hello/morpheus-board-top/README.md

Hello Morpheus Top Board repository 
===
