hello/morpheus-board-top/Morpheus_top/Morpheus_top_091614.xlsx

Comment | Description | Designator | Footprint | LibRef | Quantity
BAL-NRF02D3 | 50 ohm balun transformer for 2.45GHz ISM | B1 | BAL-ST-WLCSP | BAL-ST-5pin_DC-Flip | 1
0.1u | Chip capacitor | C1, C2, C3, C9, C11, C14, C16, C23, C44, C61 | CAP0402 | C_0.1u_10_50_X7R_0402 | 10
12p | Chip capacitor | C4, C5, C52, C53 | CAP0402 | C_12p_5_50_C0G_0402 | 4
1000p | Chip capacitor | C6 | CAP0402 | C_1000p_10_50_X7R_0402 | 1
0.047u | Chip capacitor | C7 | CAP0402 | C_0.047u_10_50_X7R_0402 | 1
2200p | Chip capacitor | C8, C20, C21, C22 | CAP0402 | C_2200p_5_16_STD_0402 | 4
4.7u | Chip capacitor | C10, C12, C17, C18, C19, C25, C26, C49 | CAP0603 | C_4.7u_20_6.3_X5R_0603 | 8
10u | Chip capacitor | C13, C24 | CAP0603 | C_10u_10_6.3_X5R_0603 | 2
22u | Chip capacitor | C15 | CAP0603 | C_22u_10_20_JB_0603 | 1
2.2 p | Chip capacitor | C32 | CAP0402 | C_2.2p_0.05_50_C0G_0402 | 1
1.0p | Chip capacitor | C33 | CAP0402 | C_2200p_5_16_STD_0402 | 1
1u | Chip capacitor | C43, C47, C48 | CAP0603 | C_1u_10_16_X5R_0603 | 3
220p | Chip capacitor | C46 | CAP0402 | C_220p_5_50_C0G_0402 | 1
4.7u | Chip capacitor | C54, C55 | CAP0402 | C_4.7u_10_10_JB_0402 | 2
100u | Chip capacitor | C56 | CAP1206 | C_100u_20_6.3_X5R_1206 | 1
Hole | general purpose hole | H1, H2, H3, H4 | HOLE_ROUND_1.7mm | Hole | 4
2.2n | SMD power inductor, 2.2uH | L1 | IND_0402 | L_2.2n_0.1_?_0.150_0.9_? | 1
SPU0414 | Knolwes Microphone | M1 | BGA4C170X246P3.00X3.75X90 | SPU0414HR5H | 1
SPH0611LR5H | Knolwes Microphone | M2 | SPH0611 | SPH0611LR5H | 1
53647-0374 | Molex 30-pin 0.635mm pitch plug connector | P1 | molex_53647-0374 | molex_53647-0374 | 1
HDR2.00-2x3-SM |  | P4, P5, P6 | HDR2.00-2X3-SMD | HDR2.00-2x3-SM | 3
Si1912EDH | Vishay Dual N-Channel MOSFET 1.8v drive 20V 1A | Q2 | SC-70-6 | Si1912EDH | 1
100K | Chip Resistor | R1 | RES0402 | R_100k_5_0.1_0402 | 1
10 | Chip Resistor | R4, R10, R44, R70, R71, R72, R73, R74, R75, R76, R77, R78 | RES0402 | R_10_1_0.1_0402 | 12
10k | Chip Resistor | R6, R61 | RES0402 | R_10k_5_0.1_0402 | 2
215K | Chip Resistor | R22, R24 | RES0402 | R_215K_1_0.1_0402 | 2
523k | Chip Resistor | R23, R25, R26, R27, R29, R30 | RES0402 | R_523k_1_0.1_0402 | 6
DNP | Chip Resistor | R28, R31, R81, R82 | RES0402 | R_0_jumper_0.1_0402, R_10k_5_0.1_0402 | 4
100 | Chip Resistor | R37, R38, R39 | RES0402 | R_100_1_0.1_0402 | 3
681 | Chip Resistor | R43 | RES0402 | R_681_1_0.1_0402 | 1
47k | Chip Resistor | R46 | RES0402 | R_47K_5_0.1_0402 | 1
AB-RTCMC-32.768kHz-AIGZ | Abracon I2C RTC w/ integrated XO | RTC0 | 8-CLCC | AB-RTCMC-32.768kHz-AIGZ | 1
2403-260-00001 | Knowles SMD speaker | SP1 | Knowles_2403-260-00001 | Knowles_2403-260-00001 | 1
nRF51822-QF | Multi-protocol Bluetooth Low Energy and 2.4GHz proprietary system-on-chip | U1 | VQFN40P600X600X100-48 | nRF51822_QF | 1
TSL4531 | Digital ambient light sensor | U2 | TSL4531 | TSL4531 | 1
NAU8814 | Nuvoton Audio Codec | U3 | QFN-24_0.5 | NAU8814 | 1
VCNL3020 | Proximity and ambient light sensor with IR emitter and I2C interface | U4 | vcnl3020 | VCNL3020 | 1
TPS79718 | LDO 1.8V SC70-5 | U11 | SOT65P212X110-5N | TPS79718DCK | 1
ILCX19-FB5F18-16.000MHz | ILSI ILCX19 16 MHz Crystal Oscillator | X1 | ILCX19 | ILCX19-FB5F18-16.000MHz | 1
FC-135 32.7680KA-AC3 | Epson 32kHz crystal, 9pF | X2 | Epson_FC-135 | Espon_FC-135 32.7680KA-AC3 | 1
ASDMB-12.000MHZ | ASDMB 12MHz Crystal Oscillator | X3 | ASDMB | ASDMB-12.000MHZ-LC-T | 1
