hello/morpheus-board-top/Morpheus_top/905-00003-EVT2.DXF

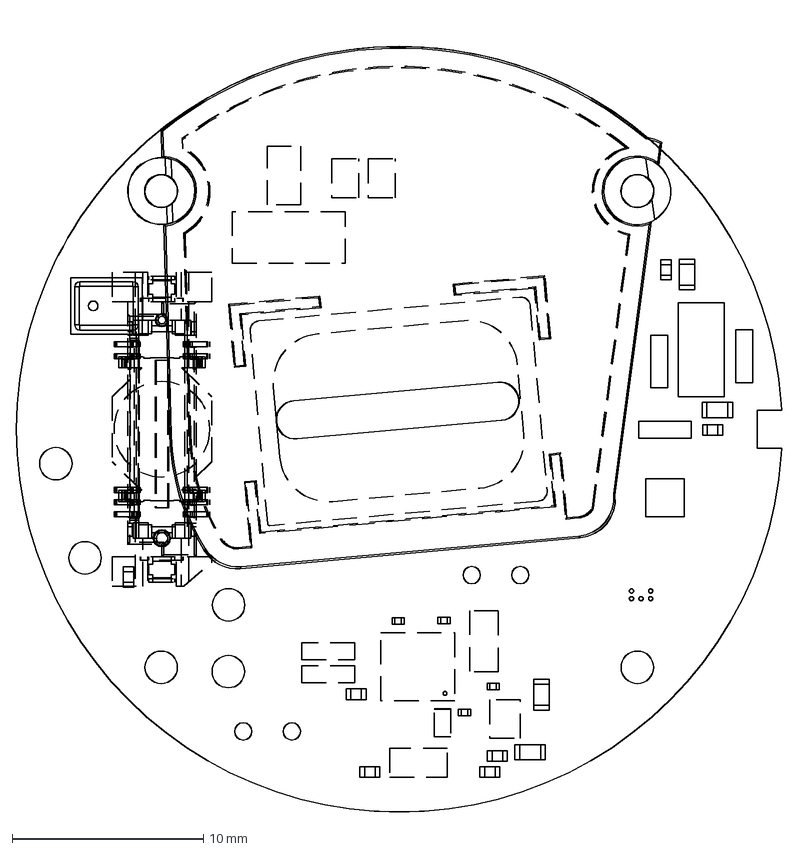
[picture p1: CAD file, 2014-11-20]
Morpheus_top/905-00003-EVT2.DXF
40.0 x 41.6 mm
