hello/morpheus-board-top/Morpheus_top/Bottom USB Board.DXF

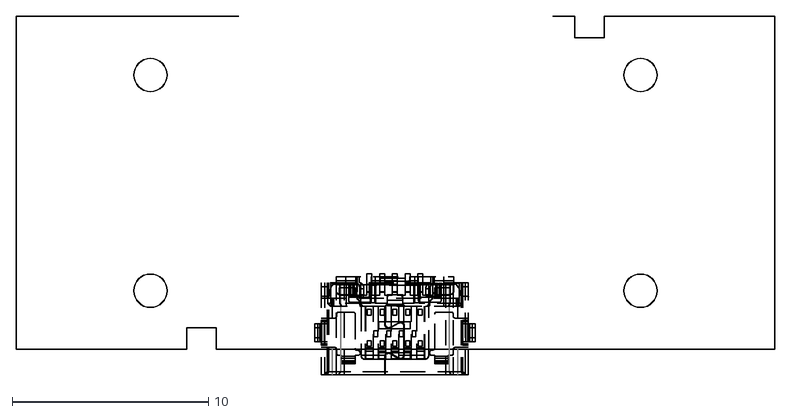
[picture p2: CAD file, 2014-11-20]
Morpheus_top/Bottom USB Board.DXF
38.7 x 18.3
