hello/morpheus-board-top/Morpheus_top/905-00003DXF.DXF

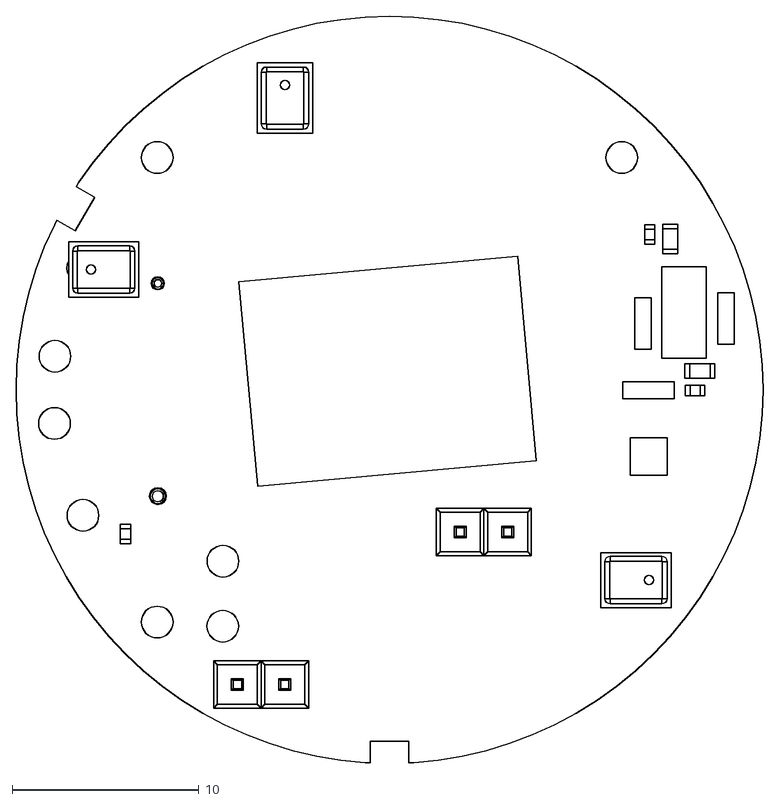
[picture p3: CAD file, 2014-11-20]
Morpheus_top/905-00003DXF.DXF
40.0 x 40.0
