hello/morpheus-board-top/Morpheus_top/905-00003-EVT3onetoone (1).DXF

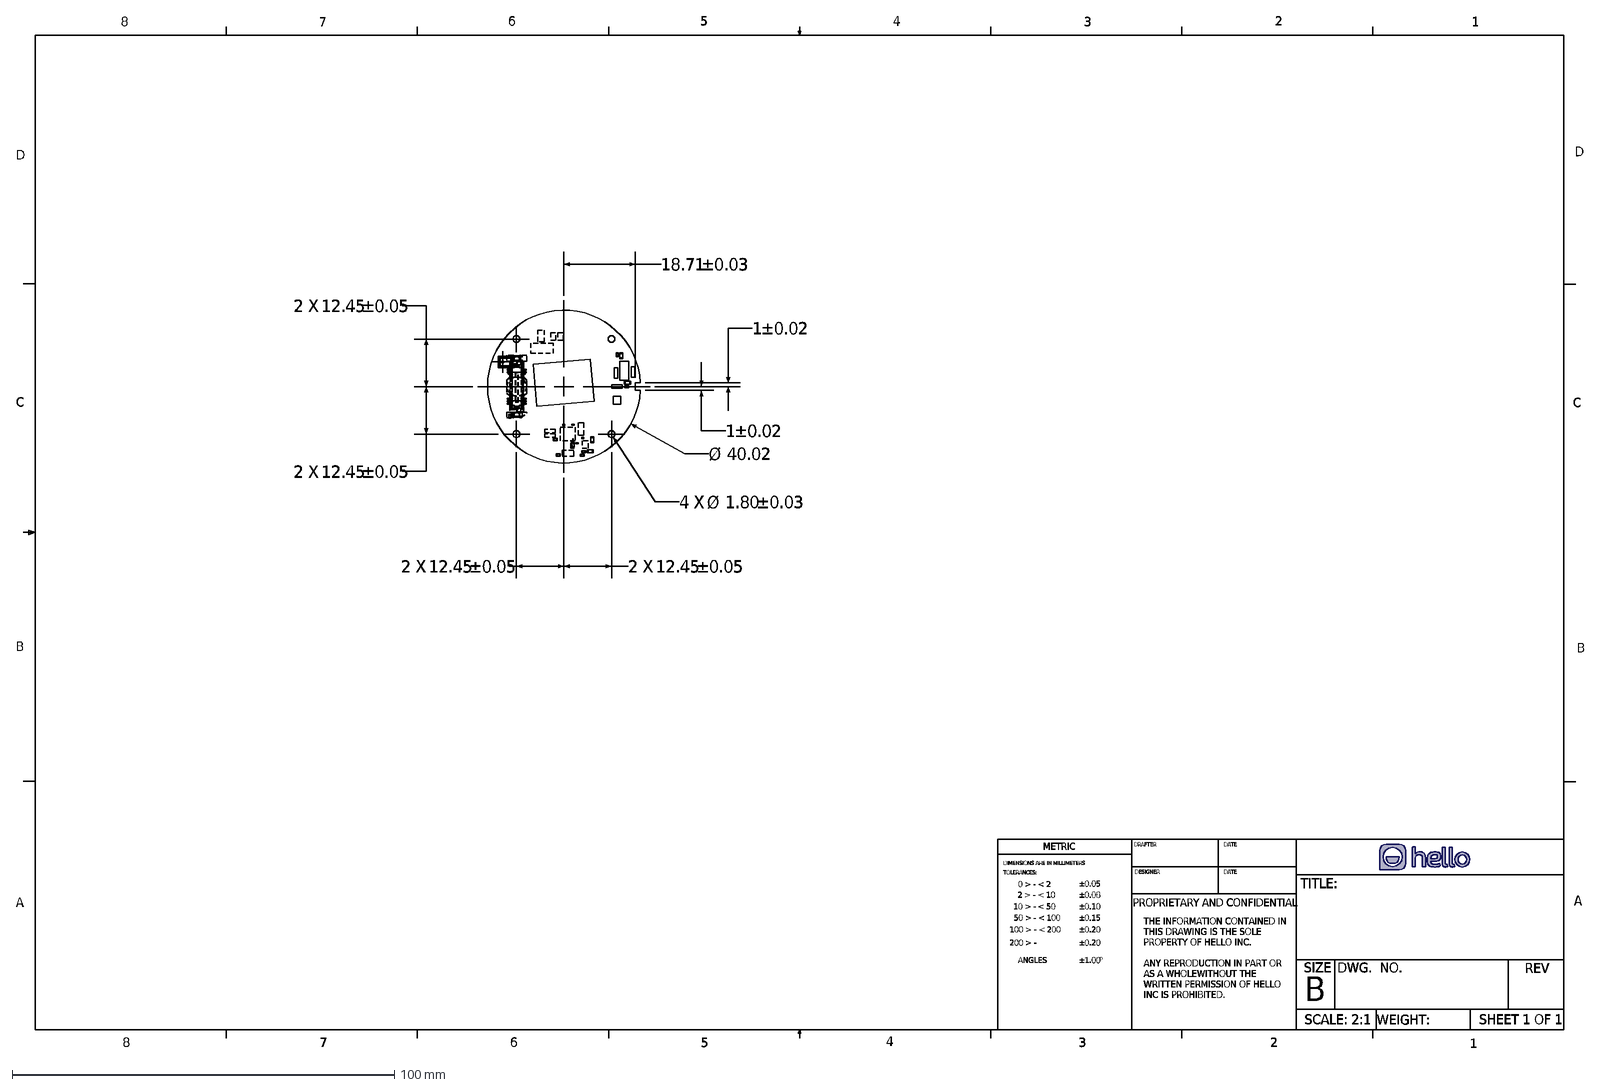
[picture p4: CAD file, 2014-11-20]
Morpheus_top/905-00003-EVT3onetoone (1).DXF
D
C
B
A
1
2
3
4
5
6
7
8
THE INFORMATION CONTAINED IN
THIS DRAWING IS THE SOLE
PROPERTY OF HELLO INC.
ANY REPRODUCTION IN PART OR
AS A WHOLEWITHOUT THE
WRITTEN PERMISSION OF HELLO
INC IS PROHIBITED.
PROPRIETARY AND CONFIDENTIAL
DIMENSIONS ARE IN MILLIMETERS
TOLERANCES:
DRAFTER
DESIGNER
DATE
TITLE:
SIZE
DWG. NO.
REV
WEIGHT:
SCALE: 2:1
METRIC
SHEET 1 OF 1
±
0.05
0 > - < 2
2 > - < 10
10 > - < 50
50 > - < 100
100 > - < 200
200 > -
0.08
0.10
0.15
0.20
ANGLES
1.00
°
4 X
Ø
1.80
±0.03
±0.02
18.71
40.02
2 X
12.45
±0.05
