hello/morpheus-board-top/Morpheus_top/40mm board.DXF

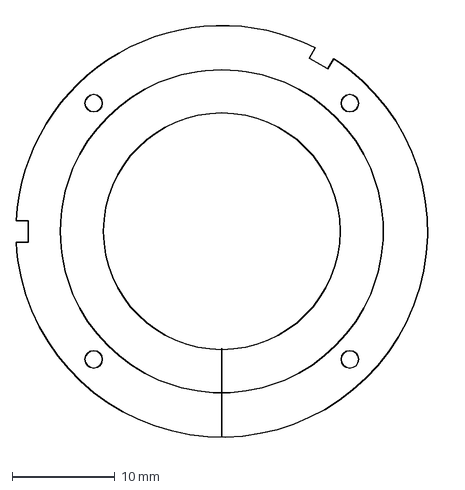
[picture p5: CAD file, 2014-11-20]
Morpheus_top/40mm board.DXF
42.0 x 42.1 mm
