hello/morpheus-board-top/Morpheus_top/Top Board only.DXF

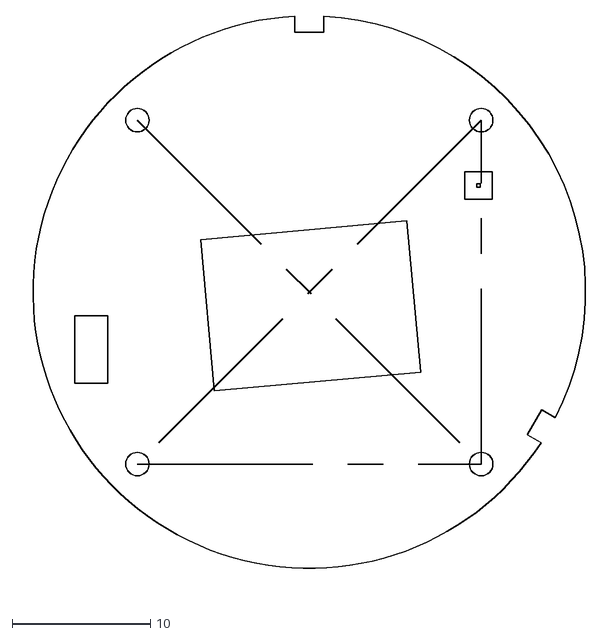
[picture p7: CAD file, 2014-11-20]
Morpheus_top/Top Board only.DXF
42.1 x 42.0
