hello/morpheus-board-top/Morpheus_top/Morpheus_top.step

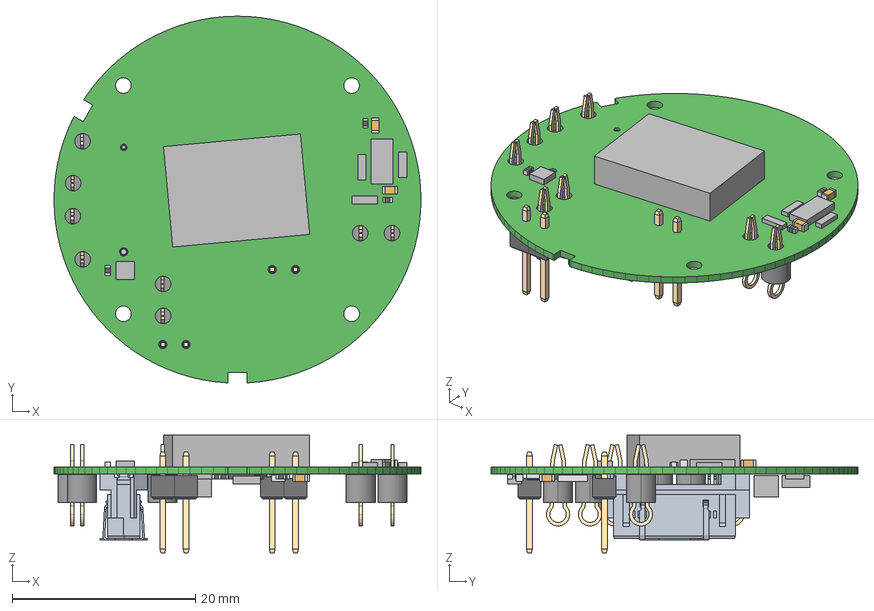
[picture p8: CAD file, 2014-06-07]
Morpheus_top/Morpheus_top.step
40.0 x 40.0 x 12.8 mm
Board
Extruded x 63
keystone_5006 x 8
User_Library-Header1x2_Header1_1 x 4
