hello/morpheus-board-top/(list of files, cad)

Other CAD files:
Morpheus_top/905-00003-04-DVTd.DWG
Morpheus_top/Antenna_sketch.DWG
Morpheus_top/Morpheus_top.DWG
