hello/morpheus-board-top/Morpheus_top/Morpheus_top_DVT_release_candidate_111414.PDF

Break Out Board Development

To the middle board

4 | | CCU_TXD

GSPI_MISO | 5 | | 8

TITLE Morpheus top | REV DVT

DATE | DRAWN BY D. Fusi | SHEET 1 OF 7

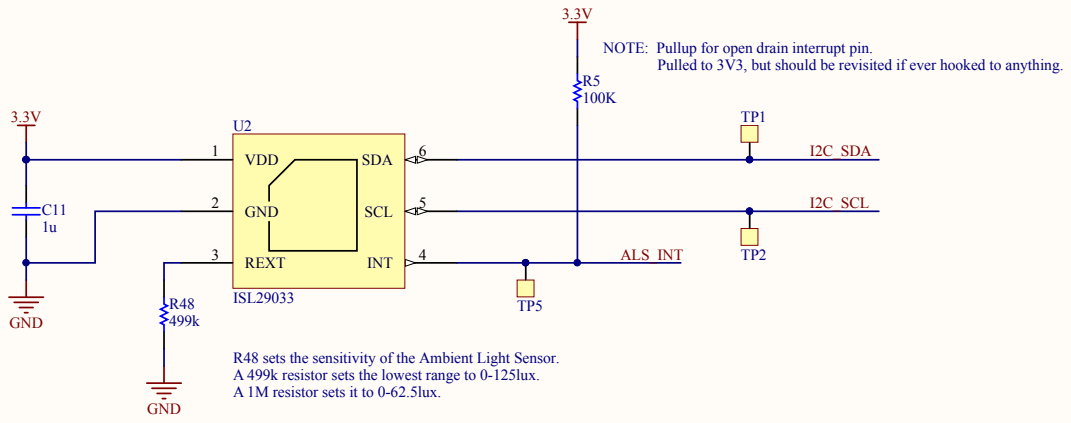
[picture p24: page 2]

NOTE: Pullup for open drain interrupt pin.

Pulled to 3V3, but should be revisited if ever hooked to anything.

R48 sets the sensitivity of the Ambient Light Sensor
A 499k resistor sets the lowest range to 0-125lux. A 1M resistor sets it to 0-62.5lux.

TITLE ALS DATE

DRAWN BY D . Fusi | S HEET 2 OF


5 | VDDC 4 | MIC+

MIC-C48 | 1u

VREF 22 | | | MIC_OUT

CSB/GPIO

EPAD 25 | MOUT

Codec

D ATE | DRAWN BY D . Fusi | S HEET 3 OF


max speaker power = 500mW
max sp7.9 mA @ 8 ohm impedance


pin 10 has to be NC according to

Proximity

D ATE | DRAWN BY D . Fusi | S HEET 5 OF


M1 is top port mic, M2 is bottom port mic. Only one can be installed at a time

High Pass Corner Frequency (32.2580645 Hz), Gain 2X


CLKOUT 2 Vss 3 Vcc 5

RTC_CLK#

FSPI_SEL | | R1 100K SWDCLK

FSPI_MISO | RTC_SDA

Install R2 to power 1.8V from middle board

LDO to provide 1.8V rather than getting it from middle board

Option for adjustable regulator version to produce ~1.85V

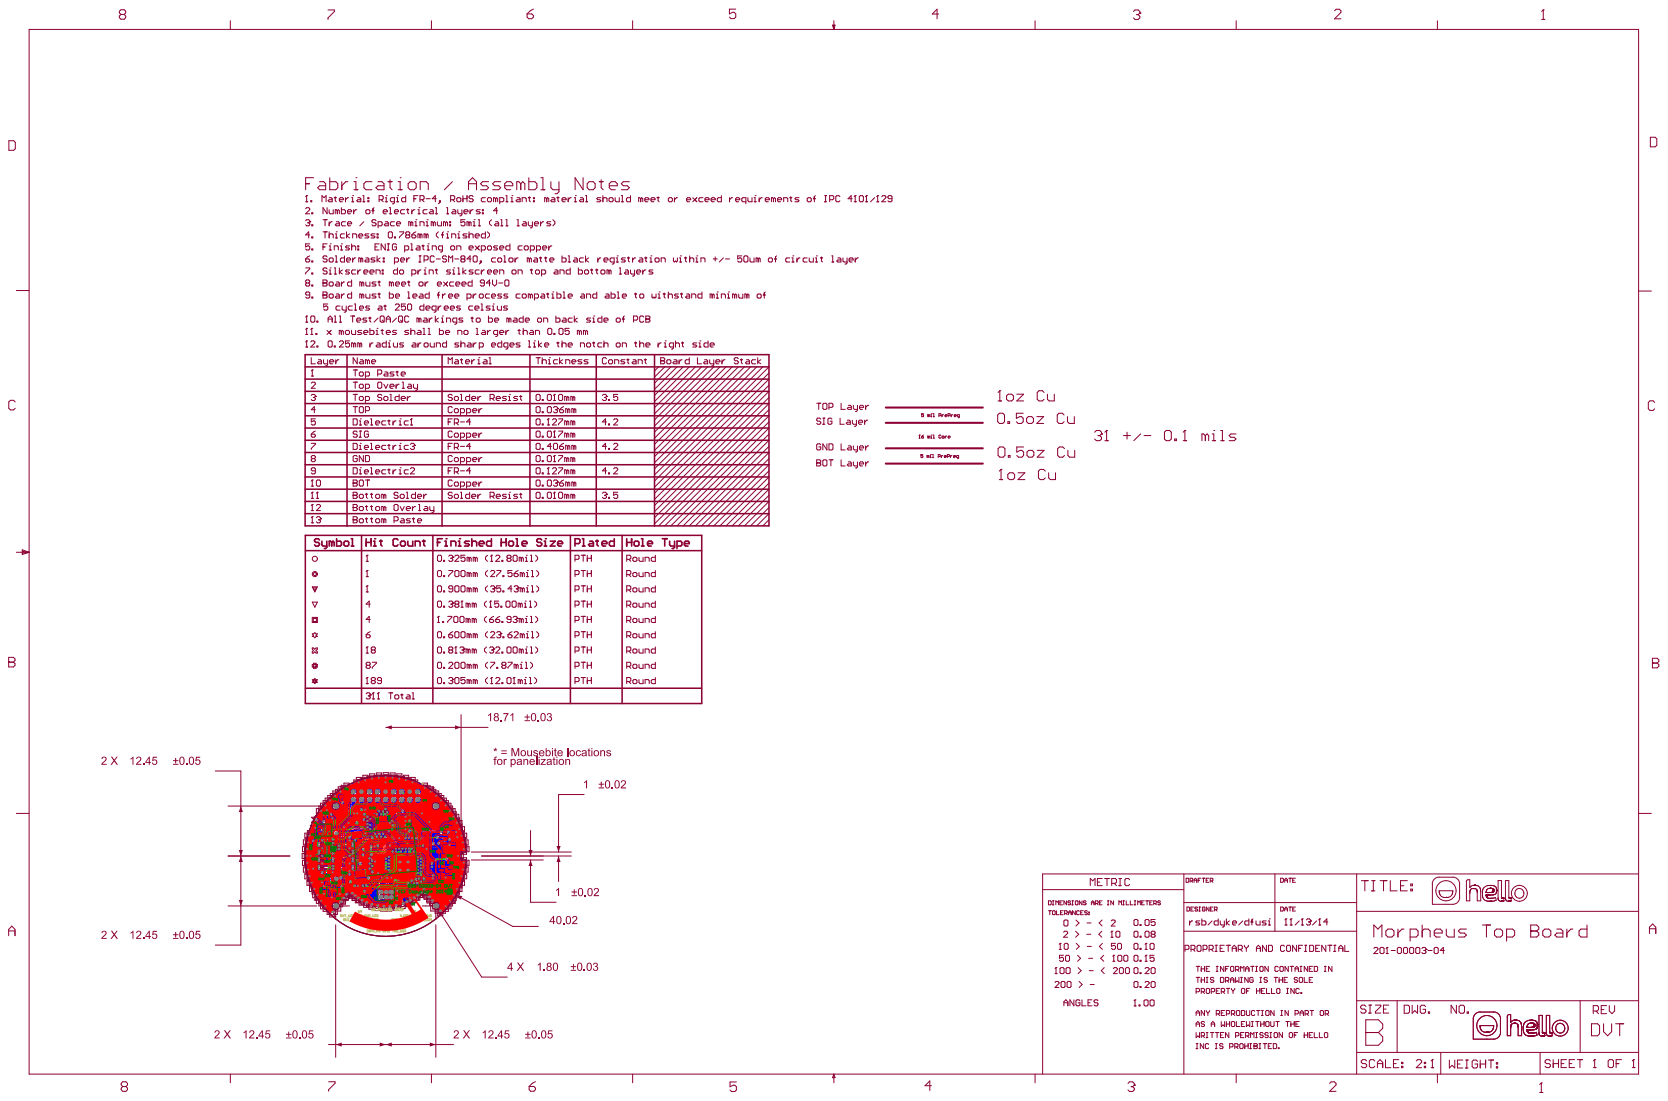
[picture p25: page 8]
