hello/morpheus-board-top/Morpheus_top/Morpheus_top.PDF

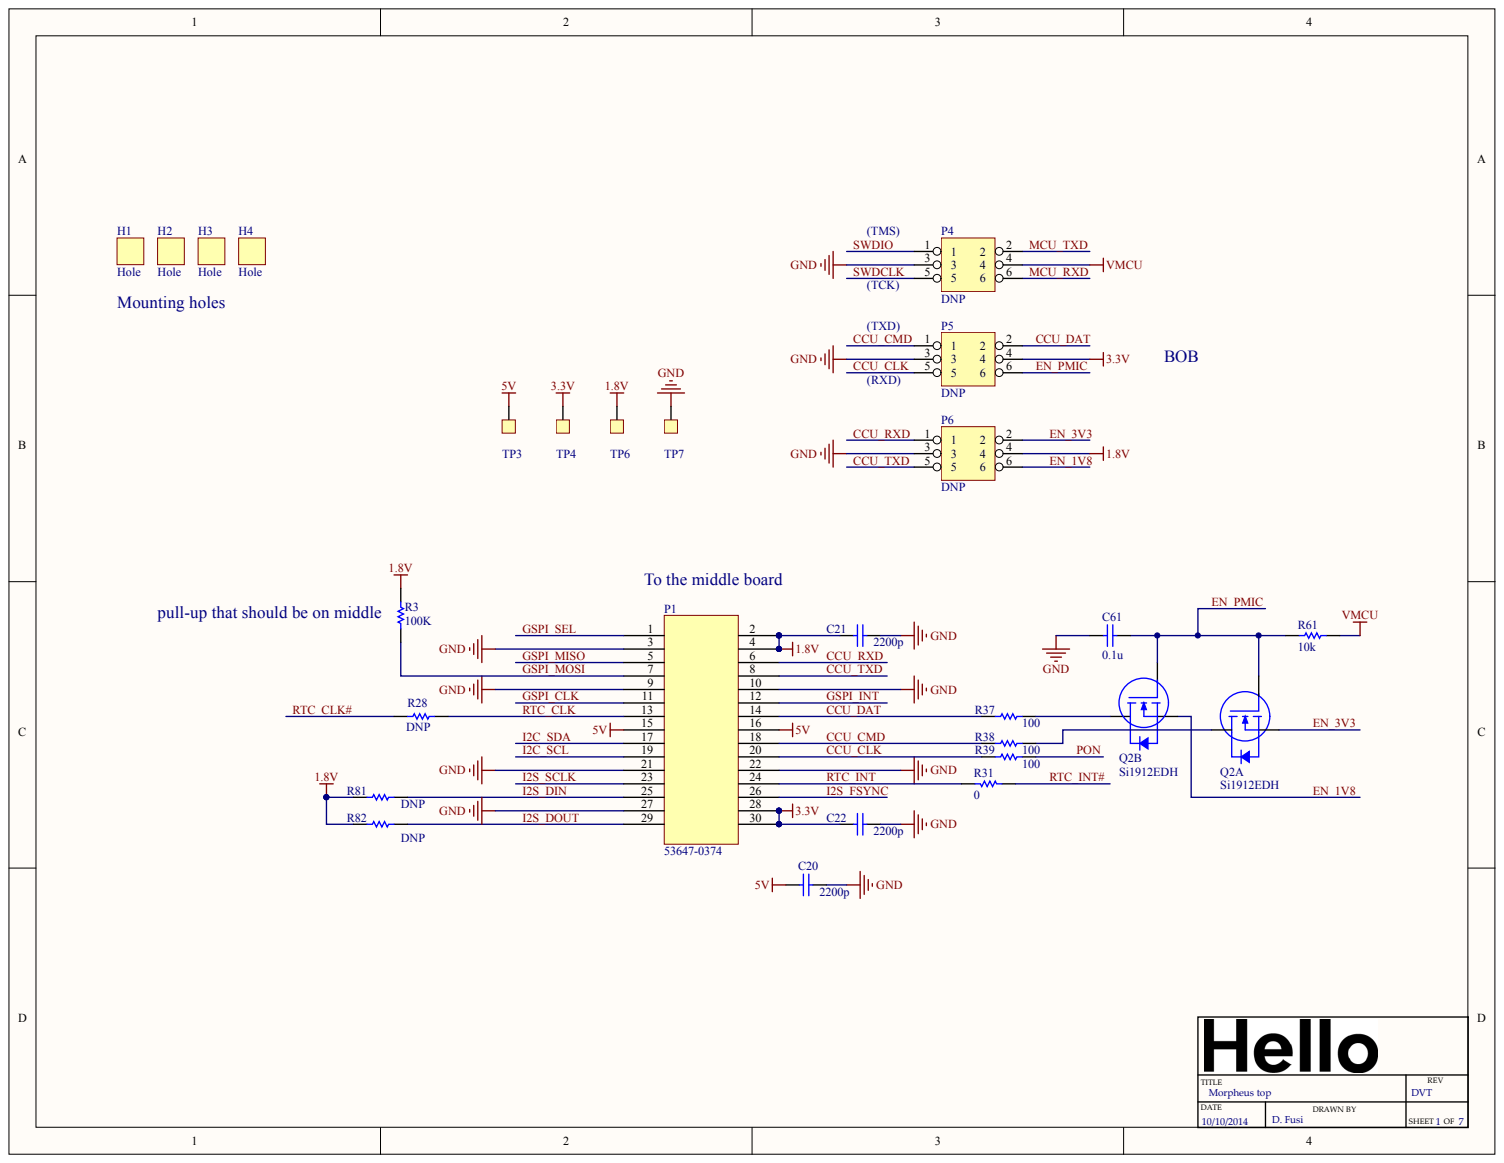
[picture p26: page 1]

To the middle board

4 | | CCU_TXD

GSPI_MISO | 5 | | 8

TITLE Morpheus top | REV DVT

DATE | DRAWN BY D. Fusi | SHEET 1 OF 7

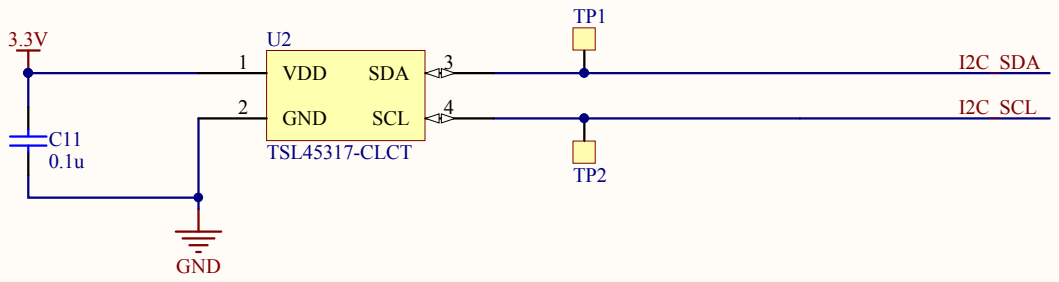
[picture p27: page 2]

TITLE ALS DATE

DRAWN BY D . Fusi | S HEET 2 OF

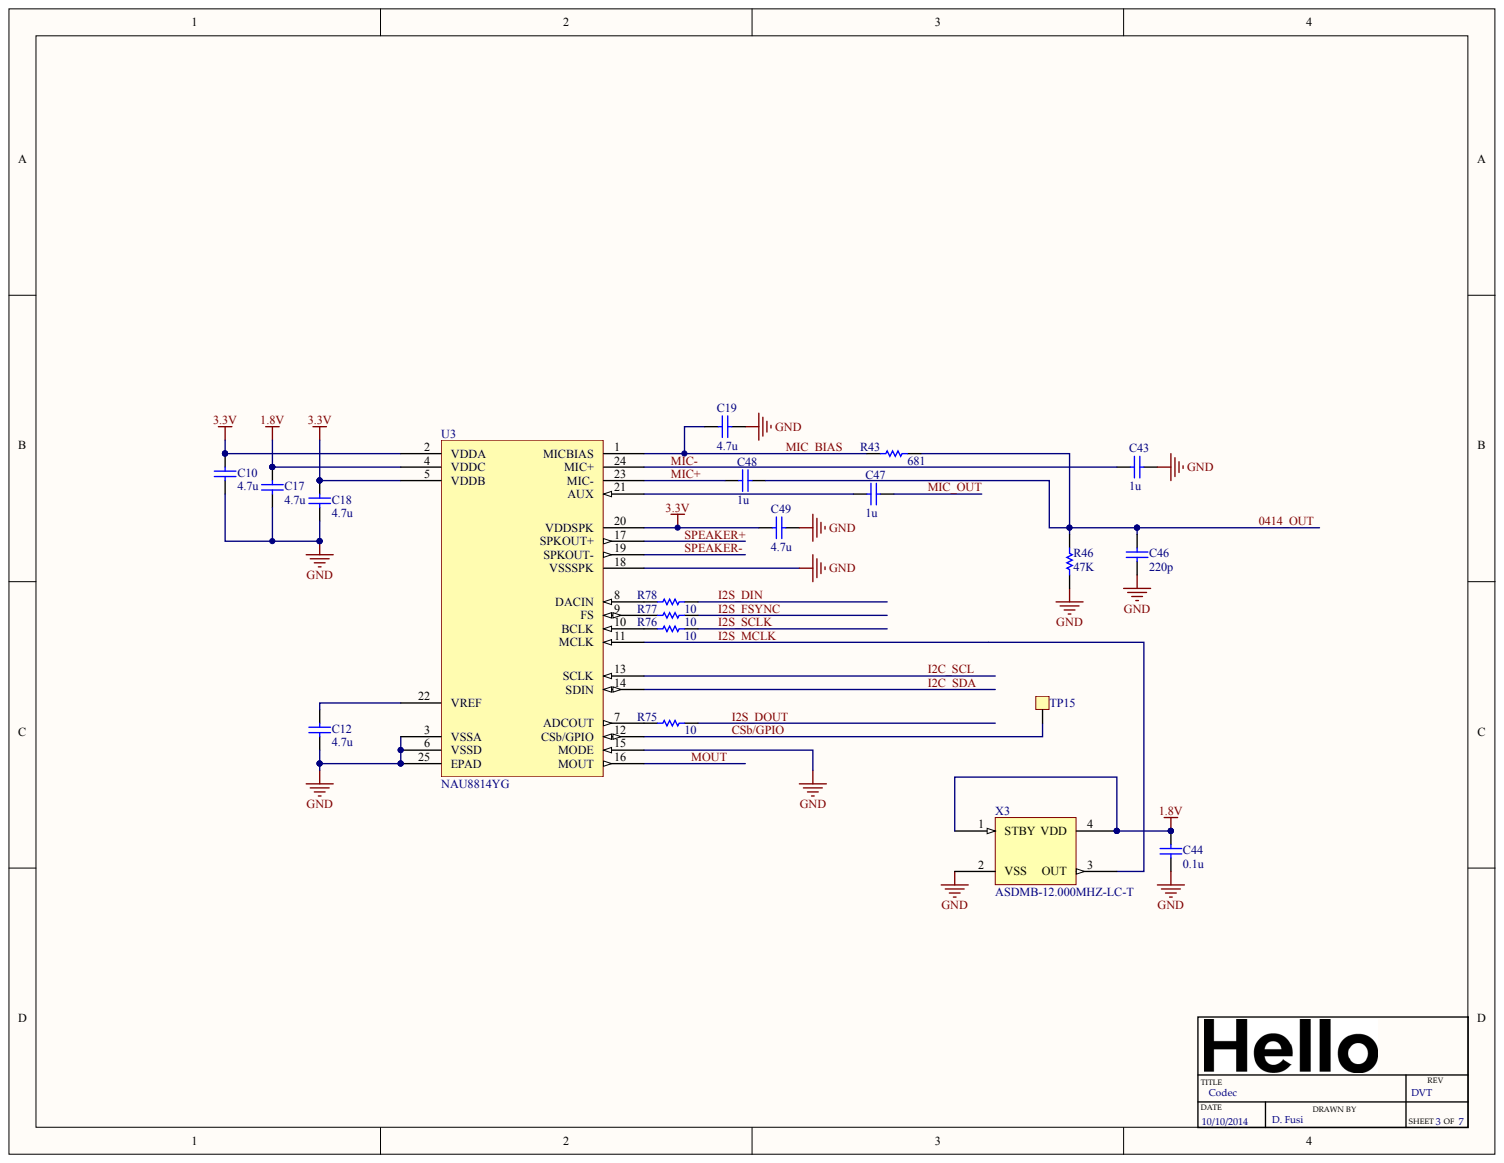
[picture p28: page 3]

5 | VDDC 4 | MIC-C48

MIC+ | C47

VREF 22 | | | MIC_OUT

10 CSb/GPIO

EPAD 25 | MOUT

Codec

ATE


max speaker power = 500mW
max sp7.9 mA @ 8 ohm impedance

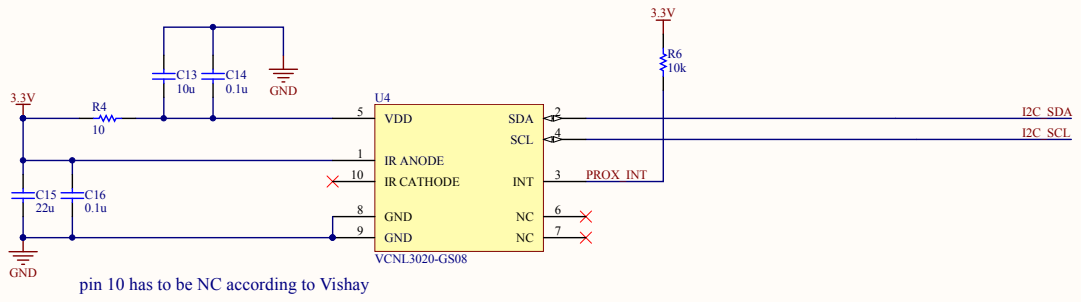
[picture p29: page 5]

pin 10 has to be NC according to

Proximity

ATE

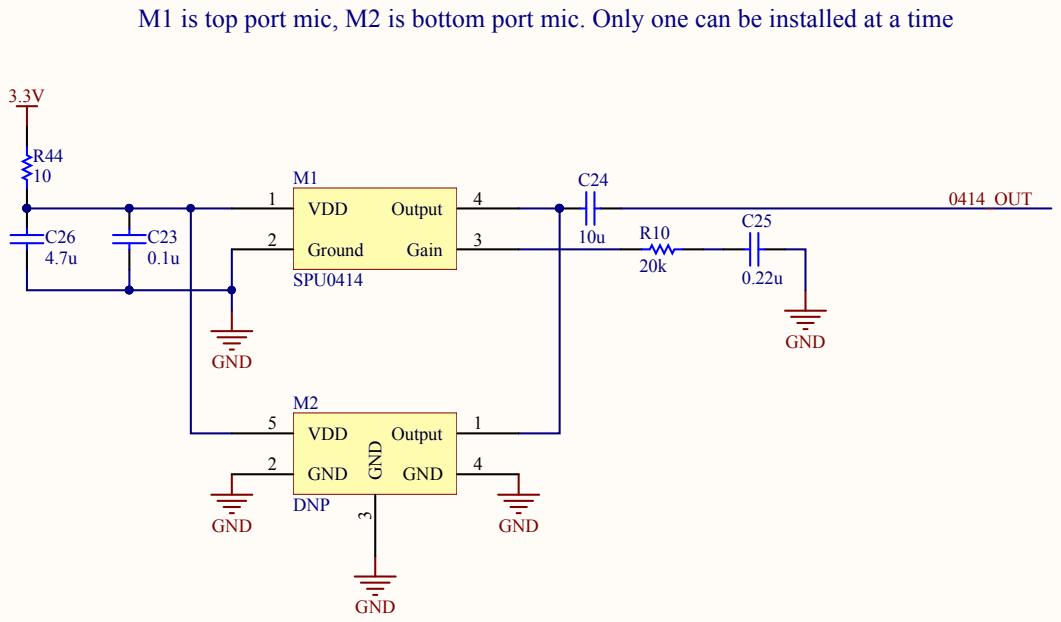
[picture p30: page 6]

M1 is top port mic, M2 is bottom port mic. Only one can be installed at a time

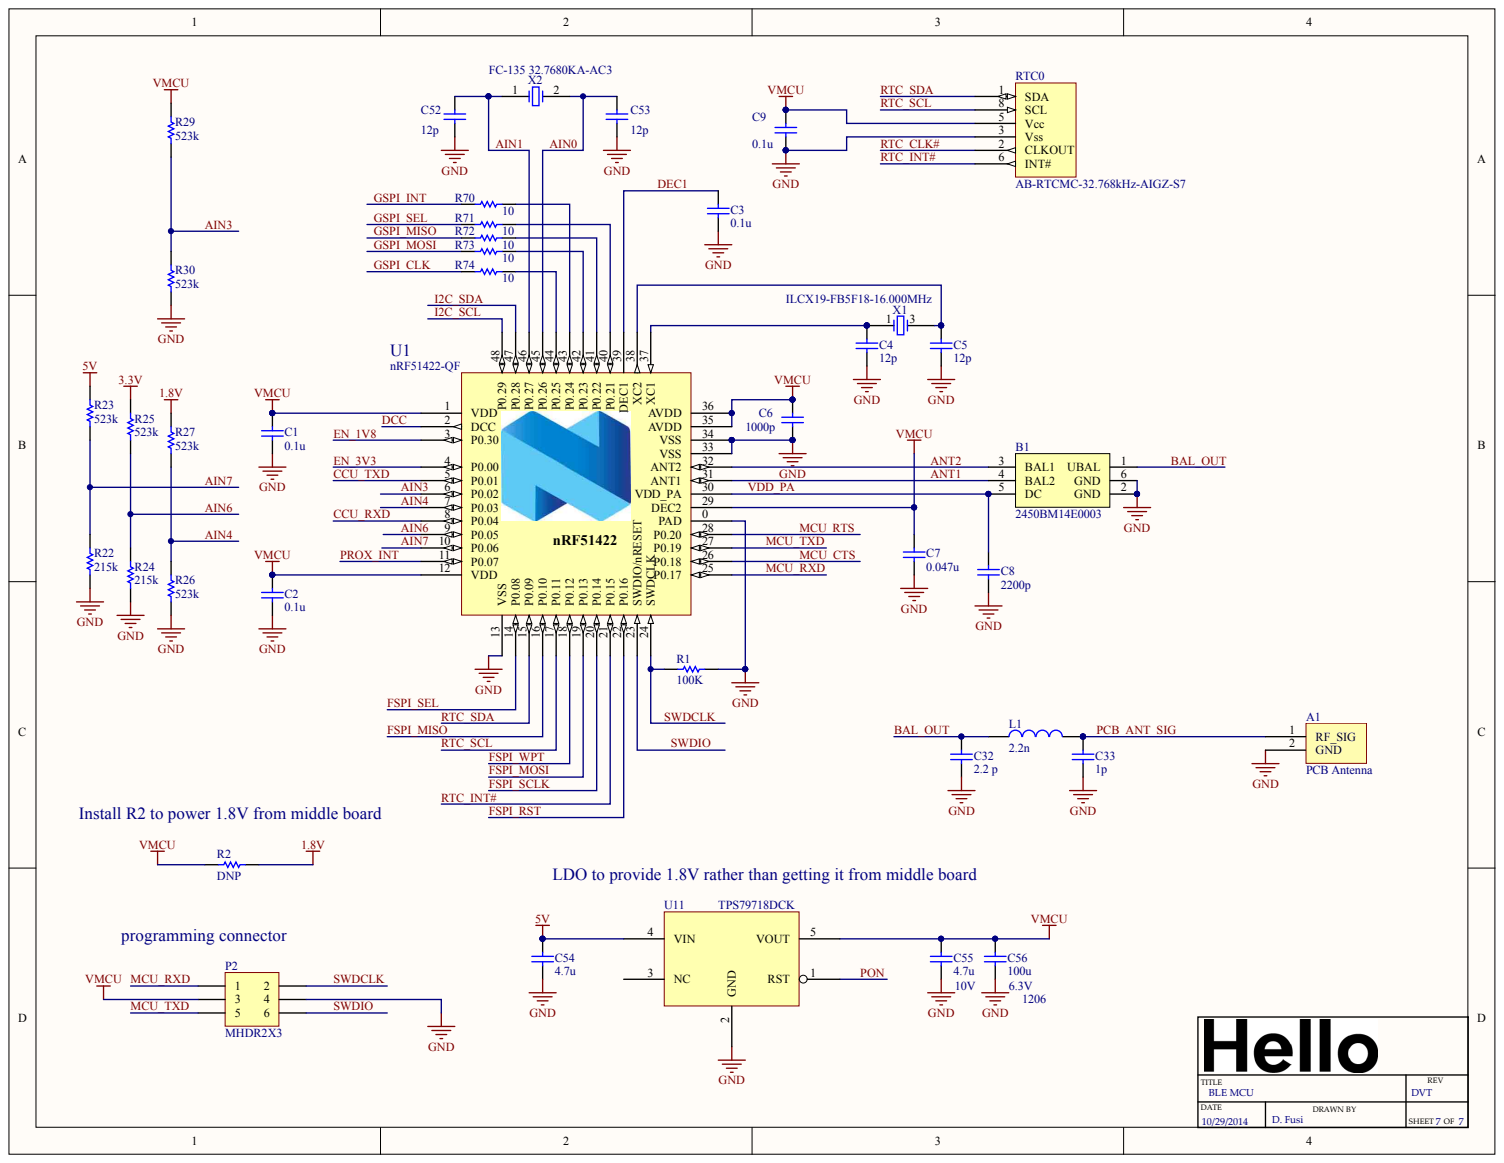
[picture p31: page 7]

CLKOUT 2 Vss 3 Vcc 5

RTC_CLK#

FSPI_SEL | | R1 100K SWDCLK

FSPI_MISO | RTC_SDA

Install R2 to power 1.8V from middle board

LDO to provide 1.8V rather than getting it from middle board
