hello/morpheus-board-top/(list of files, drawings)

Other design files:
Heartrate_Board/heartrate_board.PrjPcb
Morpheus_top/ALS.SchDoc
Morpheus_top/Bluetooth_MCU.SchDoc
Morpheus_top/Codec.SchDoc
Morpheus_top/LEDs.SchDoc
Morpheus_top/Memory.SchDoc
Morpheus_top/Microphone.SchDoc
Morpheus_top/Morpheus_top.PcbDoc
Morpheus_top/Morpheus_top.PcbLib
Morpheus_top/Morpheus_top.PrjPcb
Morpheus_top/Morpheus_top.SchDoc
Morpheus_top/Morpheus_top_meander_only.PcbDoc
Morpheus_top/Proximity.SchDoc
Morpheus_top/Speaker.SchDoc
