hello/morpheus-board-top/(commit log)

2013-04-03 adding all of jim's schematics
    [gpsANTonly.pcb, pcbREV4(nordicMicro).pcb, pcbREV4(nordicMicro).sch, pcbREV4b(nordicMicro&telit).pcb, pcbREV4b(nordicMicro&telit).sch, pcbREV5(telit-test).pcb, pcbREV5(telit-test).sch, prgmBRD.pcb]
2013-04-11 Organizing by design and revision
    [Band.pcb, Band.sch, gpsANTonly.pcb, pcbREV4b(nordicMicro&telit).pcb, pcbREV4b(nordicMicro&telit).sch, pcbREV5(telit-test).pcb, pcbREV5(telit-test).sch, prgmBRD.pcb]
2013-04-11 Add proper antenna layout to be merged into Rev4
    [GPS Antenna Layout.pcb]
2013-04-11 Update Band with Telit GPS
    [Band.pcb, Band.sch, Board.pcb, Board.sch, GPS Antenna Layout.pcb]
2013-04-11 Add development board version of Rev4b
    [Band Dev Board.pcb, Band Dev Board.sch]
2013-04-11 Add JTAG breakout board
    [JTAG Breakout.pcb, JTAG Breakout.sch]
2013-04-11 Add HeartRate dev board
    [HeartRate.pcb, HeartRate.sch]
2013-04-18 Remove old band pcb and schematic
    [Band.pcb, Band.sch]
2013-04-18 Initial Hello Footprint library
    [Hello.PcbLib]
2013-04-18 Import Nordic nRF51822 component library for Altium
    [nRF51822-QFAA_ST_BAL-NRF01D3.PcbLib, nRF51822-QFAA_ST_BAL-NRF01D3.SCHLIB]
2013-04-18 Initial Band project layout in Altium
    [Band.PcbDoc, Band.PrjPCB, Band.SchDoc, Bluetooth MCU.SchDoc, GPS.SchDoc, HeartRate.SchDoc, Motion.SchDoc, Power.SchDoc]
2013-04-18 Corrected LGA-28 footprint for LSM330DLC
    [Hello.PcbLib]
2013-04-19 Added Savvis M830110 GPS Antenna Footprint
    [Hello.PcbLib]
2013-04-19 Correct MB830110 pin numbering
    [Hello.PcbLib]
2013-04-19 Add footprint for Rakon RSX-10 xtal
    [Hello.PcbLib]
2013-04-19 Add footprint for Macronix NOR Flash
    [Hello.PcbLib]
2013-04-19 Add Savvi M310210 Bluetooth Antenna footprint
    [Hello.PcbLib]
2013-04-19 Added footprint for Molex JTAG connector
    [Hello.PcbLib]
2013-04-19 Updated JTAG connector footprint
    [Hello.PcbLib]
2013-04-19 Reference Hello.pcblib from Band project
    [Band.PrjPCB, Hello.PcbLib]
2013-04-19 Add Hello.SchLib with Macronix Flash Component
    [Hello.SchLib]
2013-04-19 Change SI/SO to MOSI/MISO
    [Hello.SchLib]
2013-04-19 Add inter-island signals
    [Band.SchDoc]
2013-04-19 Add Hello.SchLib to the Band project
    [Band.PrjPCB]
2013-04-20 Added LSM330DLC Component
    [Hello.SchLib]
2013-04-20 Add LSM330DLC to Motion Sub-board
    [Motion.SchDoc]
2013-04-20 Remove pin 1 silkscreen dots
    [Hello.PcbLib]
2013-04-20 Connect nets on Motion schematic
    [Motion.SchDoc]
2013-04-20 Change the name of the islands
    [Bluetooth MCU.SchDoc]
2013-04-20 Started layout of Motion island
    [Band.PcbDoc]
2013-04-22 added CRS04 schottky diode ot Hello.PcbLib
    [HeartRate.SchDoc, Hello.PcbLib]
2013-04-22 Add more signal nets to Motion Island schematic
    [Motion.SchDoc]
2013-04-22 Layout of Motion Island
    [Band.PcbDoc]
2013-04-22 Add more signals to Motion Island
    [Band.SchDoc]
2013-04-22 added BPW 34 photodiode to Hello.PcbLib
    [Hello.PcbLib]
2013-04-22 added LED driver footprint to Hello.PcbLib
    [Hello.PcbLib]
2013-04-22 Sync Sheet Symbols and Ports for Motion Island
    [Band.SchDoc, Motion.SchDoc]
2013-04-22 Configure buses for Motion Island
    [Band.SchDoc]
2013-04-22 Sync Sheet Symbols and Ports for BLE MCU Island
    [Band.SchDoc, Bluetooth MCU.SchDoc]
2013-04-22 added led driver schematic component to schlib
    [HeartRate.SchDoc, Hello.SchLib]
2013-04-22 adding CRS04 to schematic library, updated HeartRateboard schematic doc
    [HeartRate.SchDoc, Hello.SchLib]
2013-04-22 Chang 1.8v nets to 1v8 net in BLE MCU Island
    [Bluetooth MCU.SchDoc]
2013-04-22 Connect together Islands via nets
    [Band.SchDoc]
2013-04-22 Add GND polygon pours and partially route BLE MCU island
    [Band.PcbDoc]
2013-04-22 added AM2520ZGC09 green LED to both PcbLib and SchLib
    [Hello.PcbLib, Hello.SchLib]
2013-04-23 added descriptions for parts I created in SchLib
    [Hello.SchLib]
2013-04-23 Resolve net weirdness and route the nets between Motion and BLE MCU Islands
    [Band.PcbDoc, Band.SchDoc, Bluetooth MCU.SchDoc, Motion.SchDoc]
2013-04-23 Changed signal name for the antenna connection on the BT balun
    [Bluetooth MCU.SchDoc]
2013-04-23 Add description for Macronix SPI NOR Flash schematic
    [Hello.SchLib]
2013-04-23 Add JTAG ZIF Socket schematic
    [Hello.SchLib]
2013-04-23 Add Savvi M310210 antenna schematic
    [Hello.SchLib]
2013-04-23 Add Savvi MB30110 GPS Antenna schematic
    [Hello.SchLib]
2013-04-23 Add Rakon RSX-10 schematic
    [Hello.SchLib]
2013-04-23 added power points in the Heart rate board schematic
    [HeartRate.SchDoc]
2013-04-23 added a schlib entry for the photodetector, added component to heartrate board schdoc
    [HeartRate.SchDoc, Hello.SchLib]
2013-04-23 added mcp6001 op amp to pcblib and schlib
    [HeartRate.SchDoc, Hello.PcbLib, Hello.SchLib]
2013-04-23 Clean up routing between Motion and BLE Islands
    [Band.PcbDoc, Band.SchDoc, Bluetooth MCU.SchDoc, Motion.SchDoc]
2013-04-23 modified photodetector in schlib, completed more of heartrate schematic
    [HeartRate.SchDoc, Hello.SchLib]
2013-04-23 fixed a few errors in heartrate baoard schdoc
    [HeartRate.SchDoc]
2013-04-23 added footprint for opamp mcp6001
    [Hello.PcbLib, Hello.SchLib]
2013-04-23 Place HR ports in band top level project
    [Band.SchDoc]
2013-04-23 Add SPI ports to GPS Island
    [GPS.SchDoc]
2013-04-23 Connect the Ports to Nets in HR schematic instead of directly to wires
    [HeartRate.SchDoc]
2013-04-23 Updated PCB with changes in HR Island
    [Band.PcbDoc]
2013-04-23 Fix pinout for MCP6001 schematic
    [Hello.SchLib]
2013-04-23 Fix pinout for LED schematic
    [Hello.SchLib]
2013-04-23 Fix centering for a couple component schematics
    [Hello.SchLib]
2013-04-23 Fix centering for BPW34 and via size for TB62755FPG
    [Hello.PcbLib]
2013-04-23 Update schematics with changes to Hello component library
    [Bluetooth MCU.SchDoc, HeartRate.SchDoc, Motion.SchDoc]
2013-04-23 Reconnect C1 and D2 in HR schematic
    [HeartRate.SchDoc]
2013-04-23 Update pin orientation on discrete components in Hello library
    [Hello.SchLib]
2013-04-23 Bring in changes from library update
    [HeartRate.SchDoc]
2013-04-23 Updated HR components placed on PCB
    [Band.PcbDoc]
2013-04-23 added a new schottky diode MSS1P4 entry to pcblib and schlib
    [Hello.PcbLib, Hello.SchLib]
2013-04-23 changed the schottky diode used in the heartrate schematic
    [HeartRate.SchDoc]
2013-04-23 fixed height of leds
    [Hello.PcbLib, Hello.SchLib]
2013-04-23 Prefix component names with HR_ for HR Island to resolve board conflicts
    [HeartRate.SchDoc]
2013-04-23 Remove via from TB62755FPG footprint
    [Hello.PcbLib]
2013-04-23 Re-link schematic with footprint for MSS1P4 schottky diode
    [Hello.SchLib]
2013-04-23 Updated components in HR Schematic with previous library updates
    [HeartRate.SchDoc]
2013-04-23 Bring PCB up-to-date with latest HR schematic changes
    [Band.PcbDoc]
2013-04-23 Remove a short between D1 Pin1 and Pin2 on HR Island schematic
    [HeartRate.SchDoc]
2013-04-23 Change HR Schematic to use more nets instead of wires
    This makes the schematic a bit easier to read and, most of all, causes
    the pins to be named something intelligible in PCB layout
    [HeartRate.SchDoc]
2013-04-23 Unknown change to make previous commit work right
    [Hello.SchLib]
2013-04-23 Fix HR_L1 pin 1 connection. Wasn't actually connected to VIN, but appeared to be
    [HeartRate.SchDoc]
2013-04-23 Move HR_C3 to improve schematic readability
    [HeartRate.SchDoc]
2013-04-23 Last two commits revised, works for reals now
    [HeartRate.SchDoc]
2013-04-24 Redefine board shape to be precisely 110.0mm x 9.0mm and place, but not route HR components
    [Band.PcbDoc]
2013-04-24 Move board shape to be on whole integer bounaries and optimize HR layout a bit
    [Band.PcbDoc]
2013-04-24 Modify MCP6001 footprint to match schematic
    [Hello.PcbLib]
2013-04-24 Connect pin 7 to GND and add back the thermal via for TB62755FPG
    [Hello.PcbLib, Hello.SchLib]
2013-04-24 Update HR Schematic with changes to TB62755FPG component
    [HeartRate.SchDoc]
2013-04-24 Change pin assignment for HR_PWM
    [Bluetooth MCU.SchDoc]
2013-04-24 Route HR Island
    [Band.PcbDoc]
2013-04-24 fixed footprint for the mss1p4 schottky diode
    [Hello.PcbLib]
2013-04-24 Add passives and clock to the BLE Island
    [Band.PcbDoc, Bluetooth MCU.SchDoc]
2013-04-24 Small fixes surrounding pin names for MB310210
    [Hello.PcbLib, Hello.SchLib]
2013-04-25 Add keepout region for M310210 footprint
    [Hello.PcbLib, Hello.SchLib]
2013-04-25 Remove pin 1 dot from WSON-8L footprint as it already has a notched corner and it causes problems in layout
    [Hello.PcbLib]
2013-04-25 Remote pin 1 dot from LGA-28 and notch the overlay
    [Hello.PcbLib]
2013-04-25 Completed first pass of BLE Island layout with antenna
    [Band.PcbDoc]
2013-04-25 Added antenna and passives to BLE Island schematic
    [Bluetooth MCU.SchDoc]
2013-04-25 Shrink down Motion Island to the board height
    [Band.PcbDoc]
2013-04-25 Reworked some via and cap placement on BLE Island
    [Band.PcbDoc]
2013-04-25 Connect SWDIO line
    [Band.PcbDoc]
2013-04-25 added entries for ads1118 adc in both pcblib and schlib
    [Hello.PcbLib, Hello.SchLib]
2013-04-25 added pcblib entry for the 42-BGA csr gps chip
    [Hello.PcbLib]
2013-04-25 added ads1118 to the heartrate board schdoc
    [HeartRate.SchDoc]
2013-04-25 Add a description and default commend / designator to ADS1118 because Roy forgot
    [Hello.SchLib]
2013-04-25 Add GSD4e schematic to library
    [Hello.SchLib]
2013-04-26 Replace resistors on HR Schematic with ones from the NRF Library
    [HeartRate.SchDoc]
2013-04-26 Remove some mechanical and silkscreen from schottky diode in library
    [Hello.PcbLib]
2013-04-26 Add Saw Filter component
    [Hello.PcbLib, Hello.SchLib]
2013-04-26 Place Saw Filter on GPS schematic
    [GPS.SchDoc]
2013-04-26 Add SPI lines to HR board
    [Band.SchDoc]
2013-04-27 Link footprint to schematic for Saw Filter
    [Hello.SchLib]
2013-04-27 Remove silkscreen and mechanicals from M830110 footprint
    [Hello.PcbLib]
2013-04-27 Modify M830110 footprint to include keepouts
    [Hello.PcbLib]
2013-04-27 Add Saw Filter and antenna cap to GPS Island
    [GPS.SchDoc]
2013-04-27 Random small BLE Island changes (oops)
    [Bluetooth MCU.SchDoc]
2013-04-27 Fix I/O directions for ports
    [Band.SchDoc]
2013-04-27 GPS antenna layout
    [Band.PcbDoc]
2013-04-29 Assign GND net to GND symbols on GPS Island
    [GPS.SchDoc]
2013-04-29 Add rule allowing short circuit in GPS antenna
    [Band.PcbDoc]
2013-04-29 added parts list for proto heartrate board
2013-04-29 just placed essential parts on heartrate_board.schdoc and created new project for prototyping the heartrate board
    [heartrate_board.PrjPcb, heartrate_board.SchDoc]
2013-04-29 Fix keepout for GPS antenna so we can put a trace on the bottom layer
    [Hello.PcbLib]
2013-04-30 Corrected I/O definition for ports
    [HeartRate.SchDoc]
2013-04-30 Fix GPS component links between PCB and Schematic
    [Band.PcbDoc]
2013-04-30 Added more components to GPS Island
    [GPS.SchDoc]
2013-04-30 Fix up port I/O directions and add GPS_CS
    [Band.SchDoc, Bluetooth MCU.SchDoc]
2013-04-30 added one potential amplification stage for the stand-alone heartrate board
    [heartrate_board.SchDoc]
2013-04-30 added test point component to PcbLib and SchLib
    [Hello.PcbLib, Hello.SchLib]
2013-04-30 updating heartrate board pcblib and schlib to reflect changes to library on branch Rev6-Devel
    [Hello.PcbLib, Hello.SchLib]
2013-04-30 fixed overlapping text in mcp6001 op amp schematic view, updated Heartrate_Board/heartrate_board.SchDoc to reflect those changes
    [Hello.SchLib, heartrate_board.SchDoc]
2013-04-30 fixed default designator for 5016 testpoint in Hello.SchLib
    [Hello.SchLib]
2013-05-01 Add BOM for the Band
2013-05-01 Minor cleanup of GPS schematic
    [GPS.SchDoc]
2013-05-01 Update PCB design with changes from previous commits
    [Band.PcbDoc]
2013-05-01 Add ILSI I587 TCXO component
    [Hello.PcbLib, Hello.SchLib]
2013-05-01 Add ILSI ILCX19 component
    [Hello.PcbLib, Hello.SchLib]
2013-05-02 Add oscillators to GPS Island
    [GPS.SchDoc]
2013-05-02 Place Oscillators on GPS Island and some routing
    [Band.PcbDoc]
2013-05-02 Change board dimensions to be 110.0mm x 10.0mm
    [Band.PcbDoc]
2013-05-02 Assign dummy net names to GPS balls that haven't been routed yet
    [GPS.SchDoc]
2013-05-02 Compact GPS layout
    [Band.PcbDoc]
2013-05-02 Add GPS ON/OFF signal
    [Band.SchDoc, Bluetooth MCU.SchDoc, GPS.SchDoc]
2013-05-02 PCB changes to reflect previous commit
    [Band.PcbDoc]
2013-05-03 Compact the GPS Island some more
    [Band.PcbDoc]
2013-05-03 Shuffle BLE IO assignments for better routing
    This commit enabled by Gogo Inflight and Virgin America
    [Bluetooth MCU.SchDoc]
2013-05-03 Further shrinking of the Accel Island
    [Band.PcbDoc]
2013-05-03 Another oops, unsure what changed in the GPS sch here...
    [GPS.SchDoc]
2013-05-14 Added TI TPS61160 footprint and schematic
    [Hello.PcbLib, Hello.SchLib]
2013-05-16 Split Storage out into its own Island
    As part of a re-org of the design to split 3v3 and 1v8 power domains
    [Motion.SchDoc, Storage.SchDoc]
2013-05-16 Add Vibration island
    [Vibe.SchDoc]
2013-05-16 Add Storage and Vibe islands to the Band schematic
    [Band.PrjPCB, Band.SchDoc]
2013-05-16 Change some passives to 0201
    [Bluetooth MCU.SchDoc, GPS.SchDoc, HeartRate.SchDoc]
2013-05-16 Re-org Islands on band to separate 3v3 from 1v8
    [Band.PcbDoc]
2013-05-16 adding footprint and schematic entry for kingbright smt green led APTL3216ZGC
    [Hello.PcbLib, Hello.SchLib]
2013-05-16 adding footprint to schematic entry for tps61160
    [Hello.SchLib]
2013-05-20 adding footprint for schottky diode ZHCS400 which is recommended for use with the TPS61160 LED driver
    [Hello.PcbLib, Hello.SchLib]
2013-05-20 Fix configuration for MISO pin
    [Band.SchDoc, Bluetooth MCU.SchDoc, GPS.SchDoc, HeartRate.SchDoc, Motion.SchDoc, Storage.SchDoc]
2013-05-21 Fix thermal via net assignment for TPS671660
    [Hello.SchLib]
2013-05-21 Remove mech15 layer from TPC61660
    [Hello.PcbLib]
2013-05-21 Switch LED driver caps to be 0201
    [HeartRate.SchDoc]
2013-05-21 Forgot what I changed here. Should involve TPS61660
    [Hello.SchLib]
2013-05-21 Fix strange problem with replacing LEDs
    [HeartRate.SchDoc]
2013-05-21 Update HR island with new LED driver
    [Band.PcbDoc]
2013-05-21 Change Island spacing to 4mm flex
    [Band.PcbDoc]
2013-05-21 Route storage and GPS islands together
    [Band.PcbDoc]
2013-05-21 Added ILSI IL3X Component
    [Hello.PcbLib, Hello.SchLib]
2013-05-21 Update GPS to use IL3X RTC
    [GPS.SchDoc]
2013-05-21 Use IL3X in GPS layout
    [Band.PcbDoc]
2013-05-21 Change capacitors to 0201 in HR Island
    [HeartRate.SchDoc]
2013-05-21 Add Panasonic resistor network component
    [Hello.PcbLib, Hello.SchLib]
2013-05-21 Use resistor networks in BTLE Island
    [Bluetooth MCU.SchDoc]
2013-05-21 Add second SPI network and place GPS and Storage on it
    [Band.SchDoc]
2013-05-21 Place resistor networks and route them
    [Band.PcbDoc]
2013-05-21 Add another Resistor Network to BLE Island
    [Bluetooth MCU.SchDoc]
2013-05-22 Re-arrange some pin assignments to facilitate routing from BTLE Island
    [Bluetooth MCU.SchDoc]
2013-05-22 Make Board 110mmx12mm to facilitate routing and adjust polygon shapes for GND planes
    [Band.PcbDoc]
2013-05-22 Finish routing together the GPS and Storage Islands to BLE Island
    [Band.PcbDoc]
2013-05-22 Set GPS nSRESET to be NC since it's pulled high internally
    [GPS.SchDoc]
2013-05-22 Set GPS WAKEUP pin to NC as it is not useful to us
    [GPS.SchDoc]
2013-05-22 Set GPS IF_TP pin to NC
    [GPS.SchDoc]
2013-05-22 Pull GPS VDDQ_0 and TMODE to GND
    [GPS.SchDoc]
2013-05-22 Update PCB with changes to GPS Island; route GPC_C2_2 net
    [Band.PcbDoc]
2013-05-23 Remote Output pin configuration from GPS Feed pin of M830110
    Made so that we can allow this pin to be connected to ground as is
    indicated in the datasheet
    [Hello.SchLib]
2013-05-23 Connect GPS_Feed pin of M830110 to GND as well as the Saw filter as is shown in the datasheet
    [GPS.SchDoc]
2013-05-23 Place cutouts around GPS_Feed line to Saw Filter to prevent GND from connecting with the trace and Saw Filter pin
    [Band.PcbDoc]
2013-05-23 Undo connecting GPS_Signal to GND as it renamed all GND nets to GPS_Signal
    [Band.PcbDoc, GPS.SchDoc]
2013-05-23 Add Torex XCL208 Component
    [Hello.PcbLib, Hello.SchLib]
2013-05-23 Add power converters and 3v3 enable port
    [Band.SchDoc, Power.SchDoc]
2013-05-23 Add 3v3_En signal and port to BLE Island
    [Bluetooth MCU.SchDoc]
2013-05-23 Remove 'ears' for inductor pins on XCL208 footprint
    [Hello.PcbLib]
2013-05-23 Layout Power Island
    [Band.PcbDoc]
2013-05-23 Rejigger some Island stuff to make layout of the remaining islands easier
    [Band.PcbDoc]
2013-05-24 Change 3.3v net to 3v3 net, route some pins
    [HeartRate.SchDoc]
2013-05-24 Shuffle some IO assignments and remove MISO from resistors
    [Bluetooth MCU.SchDoc]
2013-05-24 More routing of IMU / HRS / Power
    [Band.PcbDoc]
2013-05-24 Re-assign some more signals for easier routing and add values to termination resistors
    [Bluetooth MCU.SchDoc]
2013-05-24 Add FET to Vibe Island
    [Vibe.SchDoc]
2013-05-24 First fully routed layout
    [Band.PcbDoc]
2013-05-29 Fix VIBE_EN_PRE pin assignment (pin 2 not GPIO)
    [Band.PcbDoc, Bluetooth MCU.SchDoc]
2013-05-29 Remove Via-in-Pad for VDD_TCXO
    [Band.PcbDoc]
2013-05-29 Remove small net antenna at 142,92 on SCL line
    [Band.PcbDoc]
2013-05-29 Clarify HRS schematic
    [HeartRate.SchDoc]
2013-05-29 Show part number for PWR_U1 and PWR_U2
    [Power.SchDoc]
2013-05-29 Bring output cap values in line with datrasheet for power regulators
    [Power.SchDoc]
2013-05-29 Pin 2 and 4 are NC, not GND for BLE X1
    [Bluetooth MCU.SchDoc]
2013-05-30 Pull GPS GPIO8 to GND as per datasheet
    [GPS.SchDoc]
2013-05-30 Pull in PCB changes from previous 2 commits
    [Band.PcbDoc]
2013-05-30 Change matching caps for GPS_RTC to 15pF
    [GPS.SchDoc]
2013-05-30 Rework power rails coming from regulators
    [Band.PcbDoc]
2013-05-30 Fix via routing and un-needed GND traces
    [Band.PcbDoc]
2013-05-30 Add LEGEND to Drill Drawing
    [Band.PcbDoc]
2013-05-30 Fix soldermask expansion for ADS1118
    [Hello.PcbLib]
2013-05-30 Re-route some power signals
    [Band.PcbDoc]
2013-05-30 Update XCL208 Schematic symbol to clarify schematics
    [Hello.SchLib]
2013-05-30 Update Power Schematic with XCL208 changes
    [Power.SchDoc]
2013-05-30 Re-arrange Power Schematic elements
    [Power.SchDoc]
2013-05-30 Place keepouts for ground plane around power controllers
    [Band.PcbDoc]
2013-05-30 Connect GPS C3 and BLE_C3 to ground
    [Band.PcbDoc]
2013-05-30 Change ILCX19 schematic to a proper XTAL symbol
    [Hello.SchLib]
2013-05-30 Update BLE schematic with new ILCX19 symbol
    [Bluetooth MCU.SchDoc]
2013-05-30 Change description of ILCX19 xtal
    [Hello.SchLib]
2013-05-30 Clean up ILCX19 layout on BLE Schematic
    [Bluetooth MCU.SchDoc]
2013-05-30 Import changes from BLE schematic update (no layout change)
    [Band.PcbDoc]
2013-05-30 Move a few elements around on BLE Schematic for clarity
    [Bluetooth MCU.SchDoc]
2013-05-30 Re-organize pin placement on TPS61160 symbol for clarity
    [Hello.SchLib]
2013-05-30 Update HRS schematic with new TPS61160 pin layout
    [HeartRate.SchDoc]
2013-05-30 Minor fix to TPS61160 pin alignment
    [HeartRate.SchDoc, Hello.SchLib]
2013-05-30 Update MCP6001 Symbol to be standard op-amp
    [Hello.SchLib]
2013-05-30 Update HRS schematic with new opamp symbol
    [HeartRate.SchDoc]
2013-05-30 Add bypass caps to HRS Op-amp
    [HeartRate.SchDoc]
2013-05-30 Update HRS layout with new bypass caps
    [Band.PcbDoc]
2013-05-30 Fix BLE X1 load cap values as per Joe's advice
    2 * (Cl - Cstray) where Cstray is ~5pF
    2 * (18pF - 5pF) = 26pF
    [Bluetooth MCU.SchDoc]
2013-05-30 Small ground plane changes
    [Band.PcbDoc]
2013-05-30 Place ground vias near each ground pad
    as per "Design-in of RF circuits"
    [Band.PcbDoc]
2013-05-30 Update description and symbol for IL3X
    [Hello.SchLib]
2013-05-30 Update description and comments for ILSI oscillators
    [Hello.SchLib]
2013-05-30 Update GPS_RTC symbol and simplify schematic
    [GPS.SchDoc]
2013-05-30 Update PCB with GPS oscillator changes
    [Band.PcbDoc]
2013-05-30 Add soldermask rule to tent vias
    [Band.PcbDoc]
2013-05-30 Reduce soldermask for USP-10B03
    Make sure they don't touch
    [Hello.PcbLib]
2013-05-30 Reduce soldermask for MCP6001
    [Hello.PcbLib]
2013-05-30 Reduce soldermask for LGA-28
    [Hello.PcbLib]
2013-05-30 Reduce soldermask for EXB18V
    [Hello.PcbLib]
2013-05-30 Reduce soldermask for CSP-5BT
    [Hello.PcbLib]
2013-05-30 Reduce soldermask for 51441-0893
    [Hello.PcbLib]
2013-05-30 Update PCB with new soldermask dimensions
    [Band.PcbDoc]
2013-05-30 Remove via-in-pad from GPS sawfilter
    [Band.PcbDoc]
2013-05-30 Shorten legs on Kingbright LED symbol
    [Hello.SchLib]
2013-05-30 Update HRS schematic with LED symbol
    [HeartRate.SchDoc]
2013-06-04 Rework some signals and GNDconnections. Add top side keepout for GND on GPS antenna
    [Band.PcbDoc]
2013-06-05 Add Hello Schematic Document Template
2013-06-05 Update schematics to use Hello template
    [Band.SchDoc, Bluetooth MCU.SchDoc, GPS.SchDoc, HeartRate.SchDoc, Motion.SchDoc, Power.SchDoc, Storage.SchDoc, Vibe.SchDoc]
2013-06-05 Re-position some wire junctions
    [Band.PcbDoc]
2013-06-05 Add ID Block for PCB artwork
    [Hello.PcbLib, Hello.SchLib]
2013-06-05 Add PCB ID Block to schematic and band
    [Band.PcbDoc, Band.SchDoc]
2013-06-05 Extend PCB ID block to more layers
    [Hello.PcbLib]
2013-06-05 Update PCB with new ID Block
    [Band.PcbDoc]
2013-06-05 Update PCB with current version of footprints
    [Band.PcbDoc]
2013-06-05 Fix ball offset for BGA48 footprint
    [Hello.PcbLib]
2013-06-05 Update PCB with BGA48, reposition package and re-route signals to accomodate
    [Band.PcbDoc]
2013-06-06 Update HRS opamp circuit based on feedback from HRS proto board
    [HeartRate.SchDoc]
2013-06-06 Remove stray net labels from GPS schematic
    [GPS.SchDoc]
2013-06-06 Shrink symbol for MSS1P4
    [Hello.SchLib]
2013-06-06 Add components to Vibe Island
    [Vibe.SchDoc]
2013-06-06 Update HRS Island with new MSS1P4 footprint
    [HeartRate.SchDoc]
2013-06-06 Shrink symbol for Kingbright LED
    [Hello.SchLib]
2013-06-06 Update HRS Island with LED changes
    [HeartRate.SchDoc]
2013-06-07 Disable Mechanical layers that are unneeded. Rename Mech 3 to Design Notes
    [Band.PcbDoc]
2013-06-07 Add Layer Stackup legend to PCB and Symbol libraries
    [Hello.PcbLib, Hello.SchLib]
2013-06-07 Add Layer Stackup to Band schematic
    [Band.SchDoc]
2013-06-08 Add Vishay Si8802DB MOSFET to libraries
    [Hello.PcbLib, Hello.SchLib]
2013-06-08 Update Vibe Island to use Si8802DB
    [Vibe.SchDoc]
2013-06-08 Update Vibe Island layout on band
    Also invalidated HRS layout, will address in an upcoming commit
    [Band.PcbDoc]
2013-06-08 Shrink Band room definition to get it out of the way
    [Band.PcbDoc]
2013-06-08 Remove ADC from HRS Island and update pins and ports accordingly
    [Band.SchDoc, Bluetooth MCU.SchDoc, HeartRate.SchDoc]
2013-06-08 Update PCB to remove ADC from HRS Island and cleanup signal routing fallout
    [Band.PcbDoc]
2013-06-09 Add MCP6002 component
    [Hello.PcbLib, Hello.SchLib]
2013-06-09 Update HRS schematic with MCP6002 Dual OpAmp
    [HeartRate.SchDoc]
2013-06-10 First stab at HRS re-layout with MCP6002
    [HeartRate.SchDoc]
2013-06-10 Improve ground plane connectivity and reduce HRS Island width
    [Band.PcbDoc]
2013-06-11 Move resistor network around to make ground plane around photosense line
    [Bluetooth MCU.SchDoc]
2013-06-11 Swap HRS and Vibe Island locations and fix up routing.
    [Band.PcbDoc]
2013-06-11 Add measurements to Design Notes layer
    [Band.PcbDoc]
2013-06-11 Route new HRS Island
    [Band.PcbDoc]
2013-06-11 Align component identifiers on the bottom side of the board
    [Band.PcbDoc]
2013-06-11 Ensure uniform alignment on HRS Island between detector and LEDs
    [Band.PcbDoc]
2013-06-12 Rework Resistor Network component schematic
    [Hello.SchLib]
2013-06-12 Normalize component naming on BLE Island
    [Bluetooth MCU.SchDoc]
2013-06-12 Update PCB with normalized BLE Island naming changes
    [Band.PcbDoc]
2013-06-12 Normalize component naming for GPS Island
    [GPS.SchDoc]
2013-06-12 Position component name overlay for GPS Island
    [Band.PcbDoc]
2013-06-12 Normalize component naming for Storage Island
    [Storage.SchDoc]
2013-06-12 Normalize component naming for IMUIsland
    [Motion.SchDoc]
2013-06-12 Position component name overlay for IMU Island
    [Band.PcbDoc]
2013-06-12 Normalize component naming for Power Island
    [Power.SchDoc]
2013-06-12 Position component names for Power Island
    [Band.PcbDoc]
2013-06-12 Remove Accel and Gyro Int2 ports
    [Band.SchDoc, Motion.SchDoc]
2013-06-12 Normalize naming for HRS Island
    [HeartRate.SchDoc]
2013-06-12 Position component names for HRS Island
    [Band.PcbDoc]
2013-06-12 Normalize component naming for Vibe Island
    [Vibe.SchDoc]
2013-06-12 Position component names for Vibe Island
    [Band.PcbDoc]
2013-06-12 Tweak some Overlay designator placements
    [Band.PcbDoc]
2013-06-12 Remove unused int2 ports from IMU Island definition
    [Band.SchDoc]
2013-06-12 Rename duplicate Cap label
    [Power.SchDoc]
2013-06-12 Re-link components to schematic
    [Band.PcbDoc]
2013-06-12 Added flex section dimensions
    [Band.PcbDoc]
2013-06-12 Change GPS antenna matching cap to 18pF as per email from Ethertronics
    [Band.PcbDoc, GPS.SchDoc]
2013-06-12 Add EVT1 marker on bottom copper
    [Band.PcbDoc]
2013-06-13 Gerber file for EVT1
2013-06-15 Added MCP73781 footprint
    [Hello.PcbLib]
2013-06-17 Update Torex part numbers on Power schematic
    [Power.SchDoc]
2013-06-17 Fix comment / value fields for passives on HRS Island
    [HeartRate.SchDoc]
2013-06-17 Fix comment / value fields for passives on GPS Island
    [GPS.SchDoc]
2013-06-17 Fix comment / value fields for passives on Power Island
    [Power.SchDoc]
2013-06-17 Add pull-up to WP# line on Storage island and fix cap comment
    [Storage.SchDoc]
2013-06-17 Fix comment / value fields for passives on Motion Island
    [Motion.SchDoc]
2013-06-17 Fix comment / value fields for passives on Vibe Island
    [Vibe.SchDoc]
2013-06-17 Fix comment / value fields for passives on BTLE Island
    [Bluetooth MCU.SchDoc]
2013-06-17 Missed a passive on BTLE Island
    [Bluetooth MCU.SchDoc]
2013-06-17 Update band with pull-up on Storage island
    [Band.PcbDoc]
2013-06-18 Add 0603 Inductor component
    [Hello.PcbLib, Hello.SchLib]
2013-06-18 Update passives values and sizes to match what parts are available
    [Band.PcbDoc, GPS.SchDoc, HeartRate.SchDoc, Power.SchDoc, Vibe.SchDoc]
2013-06-18 Add 0402 footprint for Inductor
    [Hello.PcbLib, Hello.SchLib]
2013-06-18 Switch to 0402 inductor for GPS saw filter
    [Band.PcbDoc, GPS.SchDoc]
2013-06-18 Add smaller pad for test point
    [Hello.PcbLib, Hello.SchLib]
2013-06-18 Add test points for battery connection to power island
    [Power.SchDoc]
2013-06-18 Add more ground pinning and test points for connecting a battery
    [Band.PcbDoc]
2013-06-18 Added 50 ohm rules to PCB design notes layer
    [Band.PcbDoc]
2013-06-18 EVT1 Rev 1 Gerber file
2013-06-18 Changes to defaults in project file from outputting gerbers
    [Band.PrjPCB]
2013-06-18 Add DNP to description for ID and Layer block components
    [Hello.SchLib]
2013-06-19 Updates to unit values and description strings
    [Bluetooth MCU.SchDoc, GPS.SchDoc, HeartRate.SchDoc, Hello.SchLib, Motion.SchDoc, Storage.SchDoc]
2013-06-19 Update PCB with description changes (no real change)
    [Band.PcbDoc]
2013-06-19 Update resistors on HRS to 0201 except R10 and R11
    [Band.PcbDoc, HeartRate.SchDoc]
2013-06-19 Update Gerber file from previous commit
2013-06-20 Changed Via placement for all but 5 vias to be >=0.3mm from edge of rooms.
    Feedback from SEP on EVT1 r2 design received on 19/6/13
    [Band.PcbDoc]
2013-06-20 Add dedicated board outline layer
    [Band.PcbDoc]
2013-06-20 Remove a net antenna on bottom layer
    [Band.PcbDoc]
2013-06-20 Re-pour ground polygons
    [Band.PcbDoc]
2013-06-25 Add missing 3D Bodies for components
    [Hello.PcbLib]
2013-06-25 Add 3D Body to BAL-NRF1D3
    [nRF51822-QFAA_ST_BAL-NRF01D3.PcbLib]
2013-06-25 Update PCB with new 3D bodies
    [Band.PcbDoc]
2013-07-20 Correct pin1 designator for si8802db
    [Hello.PcbLib]
2013-07-20 Correct G,D pin ordering on si8802db
    [Hello.SchLib]
2013-07-20 Update schematics with fixed si8802db symbol
    [HeartRate.SchDoc, Vibe.SchDoc]
2013-07-20 Update PCB layout with corrected si8802db placement and routing
    [Band.PcbDoc]
2013-07-20 Replace nRF QFN part with WLCSP part
    [Band.PcbDoc, Bluetooth MCU.SchDoc]
2013-07-23 Add MPU-6500 component
    [Hello.PcbLib, Hello.SchLib]
2013-07-23 Switch IMU IC to MPU-6500
    [Motion.SchDoc]
2013-07-23 Remove unused IMU ports and standardize port naming in general
    [Band.SchDoc, GPS.SchDoc, HeartRate.SchDoc, Storage.SchDoc, Vibe.SchDoc]
2013-07-23 Some nRF51822 WLCSP schematic transition work
    [Bluetooth MCU.SchDoc]
2013-07-24 Remove Via-in-pad from GSD4e on GPS Island
    [Band.PcbDoc]
2013-07-26 Add TI bq51050bq component
    [Hello.PcbLib, Hello.SchLib]
2013-07-26 Add nBATT_CHG port and place bq51050b part on Power Island
    [Band.SchDoc, Bluetooth MCU.SchDoc, Power.SchDoc]
2013-07-30 Fix A3_1 and A3_2 designators for U8
    [Power.SchDoc]
2013-07-30 Add GND Planes and internal signal layers for SEP 4/2 layer stackup
    [Band.PcbDoc]
2013-07-30 Remove stale net from RN4
    [Bluetooth MCU.SchDoc]
2013-07-30 Change source ping for IMU_nCS_PRE
    [Bluetooth MCU.SchDoc]
2013-07-30 Route some SPI0 signals
    [Band.PcbDoc]
2013-07-30 Add RTC to BLE MCU
    [Band.PcbDoc]
2013-07-30 Place RTC on BLE Island
    [Bluetooth MCU.SchDoc]
2013-07-30 Correct RTC pin assignment for BLE MCU
    [Bluetooth MCU.SchDoc]
2013-07-30 Update PCB with schematic changes
    [Band.PcbDoc]
2013-08-04 Swap pin assignments and ordering for SPI_1 nets
    [Bluetooth MCU.SchDoc]
2013-08-04 Route SPI_1 and power nets
    [Band.PcbDoc]
2013-08-05 Remove MCU RTC lead from GPS_ON_OFF net
    [Bluetooth MCU.SchDoc]
2013-08-05 Remove C9 from MISO_1 net
    [Bluetooth MCU.SchDoc]
2013-08-05 Relocate pin 1 marker for XCL809 footprint
    [Hello.PcbLib]
2013-08-05 Reduce room height to 10mm
    [Band.PcbDoc]
2013-08-06 Re-align IMU in new island size
    [Band.PcbDoc]
2013-08-06 Re-assign more MCU signals for easier routing
    [Bluetooth MCU.SchDoc]
2013-08-06 Route more MCU signals
    [Band.PcbDoc]
2013-08-15 Fix layer stackup for Cirrex build and re-route SPI-1 accordingly
    [Band.PcbDoc]
2013-08-15 Tweak via placement and minor routing
    [Band.PcbDoc]
2013-08-16 Redefine board shape and fix some cutouts
    [Band.PcbDoc]
2013-08-16 Remove stray cutout from last commit
    [Band.PcbDoc]
2013-08-17 Fix polygon cutouts for ground planes
    [Band.PcbDoc]
2013-08-19 Add AB-RTCMC-32.768kHz-AIGZ to component library
    [Hello.PcbLib, Hello.SchLib]
2013-08-19 Change 8-CLCC pads to be on Top Layer only
    [Hello.PcbLib]
2013-08-19 Remove second HRS LED and sensor
    [HeartRate.SchDoc]
2013-08-19 Add RTC module to BLE MCU and re-assign signals
    [Bluetooth MCU.SchDoc]
2013-08-19 Update PCB with previous schematic changes
    [Band.PcbDoc]
2013-08-19 Add in a forgotten trace to BLE de-coupling caps
    [Band.PcbDoc]
2013-08-19 Add our own 0201 CAP component
    [Hello.PcbLib, Hello.SchLib]
2013-08-19 Update BLE island with our CAP0201
    [Bluetooth MCU.SchDoc]
2013-08-19 Update PCB layout with new CAP0201
    [Band.PcbDoc]
2013-08-19 Update IMU island and PCB with CAP0201
    [Band.PcbDoc, Motion.SchDoc]
2013-08-19 Update Storage island and PCB with CAP0201
    [Band.PcbDoc, Storage.SchDoc]
2013-08-20 Update Power island and PCB with CAP0201
    [Band.PcbDoc, Power.SchDoc]
2013-08-20 Update GPS island and PCB with CAP0201
    [Band.PcbDoc, GPS.SchDoc]
2013-08-20 Remove snap grid from 8CLCC footprint
    [Band.PcbDoc, Hello.PcbLib]
2013-08-20 Fix keepouts for BLE antenna
    [Band.PcbDoc]
2013-08-20 Add Vibe Motor component to libraries
    [Hello.PcbLib, Hello.SchLib]
2013-08-20 Place proper Vibe Motor symbol on Vibe Island
    [Vibe.SchDoc]
2013-08-20 Re-arrange Islands to facilitate Battery inegration
    Move Vibe to left end on board, move IMU next to HRS and extend flex
    between BLE and GPS islands to relieve stress on the joints at that
    bend.
    [Band.PcbDoc]
2013-08-20 Add missing rigid measurement for Power Island
    [Band.PcbDoc]
2013-08-20 Correct Y dimension on Board Shape layer
    [Band.PcbDoc]
2013-08-21 Add AMS TSL12PFN part
    [Hello.PcbLib, Hello.SchLib]
2013-08-21 Add footprint to TSL12PFN symbol
    [Hello.SchLib]
2013-08-21 Bring in changes from HRS-EM2 to HRS island
    [HeartRate.SchDoc]
2013-08-21 Update HRS with changes from TSL12PFN part
    [HeartRate.SchDoc]
2013-08-21 Update HRS PCB with new parts
    [Band.PcbDoc]
2013-08-21 Place net name to make routing more clear on HRS island
    [HeartRate.SchDoc]
2013-08-21 Initial tight routing of HRS island
    [Band.PcbDoc]
2013-08-22 Fixed Cap naming and converted more caps to our footprint
    [HeartRate.SchDoc, Power.SchDoc]
2013-08-22 Changed width of Overlay outline for 8-CLCC footprint
    [Hello.PcbLib]
2013-08-22 Fix Designator font size, re-route 3v3 for HRS and add aux vibe pads
    [Band.PcbDoc]
2013-08-22 Add some polygons to ensure GND connections
    [Band.PcbDoc]
2013-08-22 Re-assign signal pins for easier routing on BLE island
    [Bluetooth MCU.SchDoc]
2013-08-22 Route BLE Island
    [Band.PcbDoc]
2013-08-23 Minor routing changes
    [Band.PcbDoc]
2013-08-26 Fix footprint for Kingbright LED
    [Hello.PcbLib]
2013-08-28 Move IMU Island 1mm to the left to accommodate curved battery
    [Band.PcbDoc]
2013-08-28 Add SSM6N42FE Dual N-ch MOSFET part
    [Hello.PcbLib, Hello.SchLib]
2013-08-28 Replace si8802db with SSM6N42FE on Vibe Island
    [Vibe.SchDoc]
2013-08-28 Replace si8802db with SSM6N42FE on HRS and add Red LED
    [HeartRate.SchDoc]
2013-08-28 Split MCP6002T-E/MC symbol into two parts
    [Hello.SchLib]
2013-08-28 Update HRS Schematic with new MCP symbol
    [HeartRate.SchDoc]
2013-08-28 Update PCB with new MOSFETs
    [Band.PcbDoc]
2013-08-30 Move HRS components to bottom layer
    [Band.PcbDoc]
2013-08-30 Fix pin spacing on bq5150 schematic symbol
    [Hello.SchLib]
2013-08-31 WIP inductive charging changes
    [Band.PcbDoc, Hello.PcbLib, Power.SchDoc]
2013-09-02 Update ID BLOCK Revision with EVT2
    [Band.PcbDoc, Hello.PcbLib]
2013-09-02 Connect HR_PWM2 line to BLE
    [Band.PcbDoc, Band.SchDoc]
2013-09-02 Route HR_PWM2 line
    [Bluetooth MCU.SchDoc]
2013-09-02 Slight trace re-alignment
    [Band.PcbDoc]
2013-09-02 Add nCS pullup to Storage
    [Band.PcbDoc, Storage.SchDoc]
2013-09-02 Add pullup to IMU nCS
    [Band.PcbDoc, Motion.SchDoc]
2013-09-02 Tweak Storage pullup schematic
    [Storage.SchDoc]
2013-09-02 Make ID and Layer blocks now show up on BOM
    [Band.SchDoc]
2013-09-02 Add ABS06 XO
    [Hello.PcbLib, Hello.SchLib]
2013-09-02 Swap ABS06 32.768kHz XO for IL3X on GPS Island
    [Band.PcbDoc, GPS.SchDoc]
2013-09-03 Cleanup BLE schematic
    [Bluetooth MCU.SchDoc]
2013-09-03 Fix component linkage between PCB and schematics
    [Band.PcbDoc]
2013-09-03 Correct R100 to R20 on Storage Island
    [Storage.SchDoc]
2013-09-04 Add default parameters to SMT Cap and rename to Cap-SMT
    [Hello.SchLib]
2013-09-04 Update Cap-SMT to not display "Value:"
    [Hello.SchLib]
2013-09-04 Add passives for Qi RX IC
    [Power.SchDoc]
2013-09-04 Fix net assignments for components connected to filtered AC1 output
    [Power.SchDoc]
2013-09-04 Place and route passives for Qi RX IC
    [Band.PcbDoc]
2013-09-04 Add registration holes to PCB
    [Band.PcbDoc]
2013-09-04 Fix XCL209 CE pull up/down R values
    [Power.SchDoc]
2013-09-04 Add test points
    [Band.PcbDoc]
2013-09-04 Add GPS_CS pullup
    [GPS.SchDoc]
2013-09-04 Add GPS_CS pullup, resolve hole-to-hole violation
    [Band.PcbDoc]
2013-09-04 Fix wire alignment on Storage schematic
    [Storage.SchDoc]
2013-09-04 Straighten GPS_MISO trace
    [Band.PcbDoc]
2013-09-04 Change R101 to R28 on IMU Island
    [Motion.SchDoc]
2013-09-04 Place Qi RX designators
    [Band.PcbDoc]
2013-09-04 Add Cap-SMT 0402 footprint
    [Hello.PcbLib, Hello.SchLib]
2013-09-04 Change C46 to 0402 from 0201
    [Power.SchDoc]
2013-09-04 Update layout to accommodate 0402 Cap
    [Band.PcbDoc]
2013-09-04 Update C45 to 0402 from 0201
    [Power.SchDoc]
2013-09-04 Update the rest of Power Island Qi Caps to 0402
    [Power.SchDoc]
2013-09-04 Update Model info for C18
    [Storage.SchDoc]
2013-09-04 Add 0306 Cap footprint
    [Hello.PcbLib, Hello.SchLib]
2013-09-04 Add models to Caps on HRS Island
    [HeartRate.SchDoc]
2013-09-04 Specify models for Caps on GPS Island
    [GPS.SchDoc]
2013-09-04 Specify Cap models on Motion Island
    [Motion.SchDoc]
2013-09-04 Update PCB with Cap changes
    [Band.PcbDoc]
2013-09-04 Change Mech layer for ABS06 3d body
    [Hello.PcbLib]
2013-09-04 Specify Cap models on BLE Island
    [Bluetooth MCU.SchDoc]
2013-09-04 Add 0603 Cap footprint
    [Hello.PcbLib, Hello.SchLib]
2013-09-04 Changes to Res-SMT
    [Hello.SchLib]
2013-09-04 Update schematics with Res-SMT symbol
    [Bluetooth MCU.SchDoc, GPS.SchDoc, HeartRate.SchDoc, Motion.SchDoc, Power.SchDoc, Storage.SchDoc, Vibe.SchDoc]
2013-09-04 Update resistors with new footprints
    [Band.PcbDoc]
2013-09-04 Convert the remainder of HRS resistors to new symbol
    [HeartRate.SchDoc]
2013-09-04 Re-route some components due to changes in resistor symbol geometry
    [Band.PcbDoc]
2013-09-04 Fit everything onto Power Island, let's see what DFM things about that.
    [Band.PcbDoc]
2013-09-04 Remove R3 since I can find no evidence as to why it's needed on the TCXO
    [GPS.SchDoc]
2013-09-04 General cleanup and R3 removal
    [Band.PcbDoc]
2013-09-04 Ran DRC, nothing should have changed
    [Band.PcbDoc]
2013-09-04 Update Layer ID Block with new flex layers
    [Hello.PcbLib]
2013-09-04 Update PCB with new Layer ID Block
    [Band.PcbDoc]
2013-09-05 Fix dimensions on Design Notes layer
    [Band.PcbDoc]
2013-09-05 Fix soldermask expansion for Mounting holes
    [Band.PcbDoc]
2013-09-06 Fix mechanical layer for Vibe motor leads
    [Hello.PcbLib]
2013-09-06 Added rules for BLE_ANT impedance and moved GPS_SIGNAL to inner layer for decreased widith to match impedance
    [Band.PcbDoc]
2013-09-07 Add test point for BATT signal
    [Band.PcbDoc]
2013-09-07 Add 2uF cap to Vibe motor
    [Band.PcbDoc, Vibe.SchDoc]
2013-09-07 Move OPAMP from 3v3 to 1v8
    [Band.PcbDoc, HeartRate.SchDoc]
2013-09-07 Re-route 1v8 for OPAMP
    [Band.PcbDoc]
2013-09-07 Remove pesky "Band" room
    [Band.PcbDoc]
2013-09-07 Fix Source / Gate connections for HRS
    [Band.PcbDoc, HeartRate.SchDoc]
2013-09-07 Fix Source / Gate assignment for Vibe MOSFET
    [Band.PcbDoc, Vibe.SchDoc]
2013-09-07 Add Pin 1 indicator to SSM6N42FE
    [Band.PcbDoc, Hello.PcbLib]
2013-09-09 Move IMU 1mm to right
    [Band.PcbDoc]
2013-09-10 Re-route board with 2.5mil clearance (todo: Power)
    [Band.PcbDoc]
2013-09-10 Change 0.17/0.3mm vias to be 0.17/0.35 on non-top layers
    [Band.PcbDoc]
2013-09-10 Finish routing Power island with 2.5mil clearance
    [Band.PcbDoc]
2013-09-11 Fix more 2.5mil clearance violations
    [Band.PcbDoc]
2013-09-11 Add fab / asm notes to drill layer
    [Band.PcbDoc]
2013-09-11 Align drill layer
    [Band.PcbDoc]
2013-09-12 Add new OpAmp component ADA4505-2
    [Hello.PcbLib, Hello.SchLib]
2013-09-12 Replace MCP6002 with ADA4505-2 on HRS island
    [HeartRate.SchDoc]
2013-09-12 Update PCB with new HRS OpAmp
    [Band.PcbDoc]
2013-09-12 Add TestPoint component
    [Hello.PcbLib, Hello.SchLib]
2013-09-12 Add TestPoints to BLE Island and layout
    [Band.PcbDoc, Bluetooth MCU.SchDoc]
2013-09-12 Add polygon pours back
    [Band.PcbDoc]
2013-09-12 Enlarge Via for BLE Balun GND
    [Band.PcbDoc]
2013-09-13 Standardize Vias to 4/12, 6/14 and 8/16mil
    [Band.PcbDoc]
2013-09-13 Expand most clearances to 3mil for Cirexx
    [Band.PcbDoc]
2013-09-13 Rename Keepout Clearance rule
    [Band.PcbDoc]
2013-09-13 Change TestPoint to be 0.4mm
    [Hello.PcbLib]
2013-09-13 Add via based TestPoint
    [Hello.PcbLib, Hello.SchLib]
2013-09-13 Add TestPoints to schematics
    [Bluetooth MCU.SchDoc, GPS.SchDoc, HeartRate.SchDoc, Motion.SchDoc, Power.SchDoc, Storage.SchDoc, Vibe.SchDoc]
2013-09-13 Route and place TestPoints
    [Band.PcbDoc]
2013-09-13 Add more GND TestPoints
    [GPS.SchDoc, HeartRate.SchDoc, Motion.SchDoc, Power.SchDoc, Storage.SchDoc]
2013-09-13 Place and route GND TestPoints
    [Band.PcbDoc]
2013-09-14 Resize and position TestPoint Designators
    [Band.PcbDoc]
2013-09-14 Remove outdated HeartRate and JTAG projects
    [HeartRate.pcb, HeartRate.sch, JTAG Breakout.pcb, JTAG Breakout.sch, heartrate_board.PrjPcb, heartrate_board.SchDoc]
2013-09-14 Add FWDL Station project skeleton
    [FWDL Station.PrjPCB, FWDL.SchDoc]
2013-09-14 Add FWDL PCB
    [FWDL.PcbDoc]
2013-09-14 Update Revision to EVT2 in schematic Sheets
    [Band.SchDoc, Bluetooth MCU.SchDoc, FWDL.SchDoc, GPS.SchDoc, HeartRate.SchDoc, Motion.SchDoc, Power.SchDoc, Storage.SchDoc]
2013-09-14 Update FWDL Project
    [FWDL Station.PrjPCB]
2013-09-14 Add Molex USB Mini-B receptacle
    [Hello.PcbLib, Hello.SchLib]
2013-09-14 Add USB and 20-pin header
    [FWDL.PcbDoc, FWDL.SchDoc]
2013-09-14 Add schematic notes
    [FWDL.SchDoc]
2013-09-14 Add FWDL schematic to project
2013-09-14 Cleanup TP labels
    [Bluetooth MCU.SchDoc]
2013-09-14 Place Pogo Pins and assign nets
    [FWDL.SchDoc]
2013-09-14 Added FTDI component libraries
    [FTDI_PCB_Public.PcbLib]
2013-09-14 Add P50-B1 component
    [Hello.PcbLib, Hello.SchLib]
2013-09-14 Add FT2232HQ USB interface
    [FWDL.PcbDoc, FWDL.SchDoc]
2013-09-14 Updated FWDL Station project file
    [FWDL Station.PrjPCB]
2013-09-14 Wire up FTDI power lines
    [FWDL.PcbDoc, FWDL.SchDoc]
2013-09-15 Split Pogo Pins out into their own schematic
    [FWDL Station.PrjPCB, FWDL.SchDoc, PogoPins.SchDoc]
2013-09-16 Place TPs for first 3 islands
    [FWDL.PcbDoc]
2013-09-16 Place BLE TPs
    [FWDL.PcbDoc]
2013-09-16 Remaining TPs placed
    [FWDL.PcbDoc]
2013-09-17 Add AT93C46E component
    [Hello.PcbLib, Hello.SchLib]
2013-09-18 Add TLV1117LV-33 component
    [Hello.PcbLib, Hello.SchLib]
2013-09-18 Add regulator, eeprom and passives for FT2232H
    [FWDL.SchDoc]
2013-09-18 Add URLs to FT2232H schematics
    [FWDL.SchDoc]
2013-09-18 WIP routing
    [FWDL.PcbDoc]
2013-09-18 Add ABM2 12MHz XO component
    [Hello.PcbLib, Hello.SchLib]
2013-09-18 Add XO and ferrite beads
    [FWDL.SchDoc]
2013-09-18 Change Caps to 0603
    [FWDL.SchDoc]
2013-09-19 Correct 10uF cap footprint size to 0603 (C39,C39
    [Power.SchDoc]
2013-09-19 Re-layout Power Island bottom layer due to cap size change
    [Band.PcbDoc]
2013-09-19 Add model # to Res networks
    [Bluetooth MCU.SchDoc]
2013-09-19 Name more nets for easier routing
    [FWDL.SchDoc]
2013-09-19 Route FT2232H
    [FWDL.PcbDoc]
2013-09-20 Add Shorted 1x2 Header component
    [Hello.PcbLib, Hello.SchLib]
2013-09-20 Remove unused pin, add TPs and nets to other pins
    [PogoPins.SchDoc]
2013-09-20 Add MAX4780 and 1.1mm TP
    [Hello.PcbLib, Hello.SchLib]
2013-09-20 Add switch and headers and connect remaining signals
    [FWDL.SchDoc]
2013-09-20 fully route FWDL board
    [FWDL.PcbDoc]
2013-09-21 Update 4.3uF caps to 0402 footprints
    [HeartRate.SchDoc, Power.SchDoc]
2013-09-21 Layout for same
    [Band.PcbDoc]
2013-10-02 Fix inverted footprint for AB-RTCMC-32.768kHz-AIGZ
    [Hello.PcbLib]
2013-10-02 Correct layout for AB-RTCMC-32.768kHz-AIGZ
    [Band.PcbDoc]
2013-10-02 Add GND via for AB-RTCMC-32.768kHz-AIGZ
    [Band.PcbDoc]
2013-10-02 Place BAL-NRF02D3 on BLE Island
    [Bluetooth MCU.SchDoc]
2013-10-02 Update PCB with BAL-NRF02D3 footprint and 3mil spacing where possible
    [Band.PcbDoc]
2013-10-03 MX25 pinout fix
    [Hello.SchLib]
2013-10-03 Fix and disconnect flash #reset pin
    [Storage.SchDoc]
2013-10-03 Change flash routing to reflect changes
    [Band.PcbDoc]
2013-10-03 Add GPS_INT from GPS C2 -> BLE I8
    [Band.SchDoc, Bluetooth MCU.SchDoc, GPS.SchDoc]
2013-10-03 Route GPS_INT
    [Band.PcbDoc]
2013-10-07 Fix solder paste expansion for Test Points
    [Hello.PcbLib]
2013-10-07 Correct GPS_nCS connection
    [Bluetooth MCU.SchDoc]
2013-10-07 Make Power Island 2mm larger, enlarge test points and mounting holes
    [Band.PcbDoc]
2013-10-07 Hide testpoint overlay text and reposition more designators
    [Band.PcbDoc]
2013-10-08 Adjust trace widths on matching components and GPS signal
    [Band.PcbDoc]
2013-10-08 Add BQ27421 gas gauge
    [Hello.PcbLib, Hello.SchLib]
2013-10-08 Add gas gauge to Power Island and hastily route
    [Band.PcbDoc, Band.SchDoc, Bluetooth MCU.SchDoc, Power.SchDoc]
2013-10-08 Tweak pin assignments to facilitate Gas Gauge I2C
    [Band.PcbDoc, Band.SchDoc, Bluetooth MCU.SchDoc, Power.SchDoc]
2013-10-08 Minor spacing corrections
    [Band.PcbDoc]
2013-10-08 Remove outdated flex material requirement
    [Band.PcbDoc]
2013-10-08 Fix designator size and placement
    [Band.PcbDoc]
2013-10-08 Fix slightly off via sizes on Storage Island
    [Band.PcbDoc]
2013-10-09 Address clearance and GND pour under BLE for SEP
    [Band.PcbDoc]
2013-10-09 Change min drill size to 5mil for SEP
    [Band.PcbDoc]
2013-10-09 Missed one 4mil hole from a testpoint
    [Band.PcbDoc]
2013-10-30 first commit on DVT1
    [Base Station 1.SchDoc, Base Station 2.SchDoc, Base Station.PrjPcb, Base Station.SchDoc, Hello.SchLib]
2013-10-31 new footprint for kingbright leds
    [Hello.PcbLib]
2013-10-31 end of day commit
    many schematic libraries added. schematic ready for review.
    [Base Station 1.SchDoc, Base Station 2.SchDoc, Base Station.PrjPcb, Hello.SchLib]
2013-10-31 added DTC114EM footprint
    [Hello.PcbLib]
2013-10-31 added TLV70033DSE footprint
    [Hello.PcbLib]
2013-10-31 added UQFN10 footprint
    [Hello.PcbLib]
2013-10-31 added CSD97376Q4M custom footprint
    [Hello.PcbLib]
2013-10-31 added Wuerth-744043331 custom footprint
    [Hello.PcbLib]
2013-10-31 UQFN10 footprint soldermask updated
    [Hello.PcbLib]
2013-10-31 added SOT-323 footprint
    project files changed too after moving to a new machine
    [Base Station.PrjPcb, Hello.PcbLib]
2013-11-01 VQFN-48 footprint added
    [Hello.PcbLib]
2013-11-01 VQFN-48 footprint updated with center GND pad
    [Hello.PcbLib]
2013-11-01 LED_Kingbrigth footprint updated
    [Hello.PcbLib]
2013-11-01 Kingbright LEDs updated with footprint information
    [Hello.SchLib]
2013-11-01 DTC114EM updated with footprint info
    [Hello.SchLib]
2013-11-01 INA199A1 symbol updated with footprint info
    [Hello.SchLib]
2013-11-01 SOT-23 footprint added
    [Hello.PcbLib]
2013-11-01 BSS138 updated with footprint info
    [Hello.SchLib]
2013-11-01 TP symbol updated (5016)
    [Hello.SchLib]
2013-11-02 schematic and layout updated, starting to do the layout
    [Base Station 1.SchDoc, Base Station 2.SchDoc, Base Station.PcbDoc, Base Station.PrjPcb]
2013-11-04 BQ500212A schematic symbol updated
    differential pair pins need different names to be assigned to a
    differential pair on the schematic
    [Hello.SchLib]
2013-11-05 new PCB shape, minor changes in the schematic
    [Base Station 1.SchDoc, Base Station 2.SchDoc, Base Station.PcbDoc]
2013-11-05 end of day commit
    several nets still to be routed on top layer, plus all gnd and power
    planes.
    [Base Station.PcbDoc]
2013-11-05 testpoint footprints
    TP-0.3 fixed (it was actually 0.4). TP-0.6 added
    [Hello.PcbLib]
2013-11-05 testpoint TP added
    includes all TP footprint we have right now
    [Hello.SchLib]
2013-11-06 schematic redesigned in a hierarchical fashion
    Base Station is the main schematic file which contains all the others
    [Base Station 1.SchDoc, Base Station 2.SchDoc, Base Station.PcbDoc, Base Station.PrjPcb, Base Station.SchDoc, Coil_Control.SchDoc, Current_Sensing.SchDoc, LEDs.SchDoc]
2013-11-07 drc errors in the layout
    trying to figure out the issue on the coil lines
    [Base Station 1.SchDoc, Base Station 2.SchDoc, Base Station.PcbDoc, Base Station.PrjPcb, Base Station.SchDoc, Coil_Control.SchDoc, Current_Sensing.SchDoc, LEDs.SchDoc]
2013-11-07 added micro_USB_B symbol and TE-2040343-2 footprint
    pcb updated as well
    [Base Station.PcbDoc, Hello.PcbLib, Hello.SchLib]
2013-11-07 USB_micro_B symbol updated, and schematic too
    [Hello.SchLib, LEDs.SchDoc, Power_Control.SchDoc]
2013-11-07 fixed symbol name for CSD97376Q4M
    [Hello.SchLib]
2013-11-08 end of day commit
    [Base Station.PcbDoc, Base Station.PrjPcb, Base Station.SchDoc, Coil_Control.SchDoc, Power_Control.SchDoc, Wireless_Power_Controller.SchDoc]
2013-11-08 end of day commit
    schematic: resistor between AGND and GND removed.
    layout: finished routing and added all necessary polygons for copper
    pours. Still need to connect AGND to GND, and waive the relative DRC
    that pops up
    [Base Station.PcbDoc, Base Station.SchDoc]
2013-11-11 Net tie component added
    useful to tie together different nets without having DRCs
    [Hello.PcbLib, Hello.SchLib]
2013-11-12 all DRCs cleared except the ones for board clearance
    committing now so to try changing the board keepout
    [Base Station.PcbDoc, Base Station.PrjPcb, Base Station.SchDoc]
2013-11-12 TE-2040343 footprint updated
    keepout lines added, so to avoid DRC when pouring copper in polygons. it
    may get other DRC because pins are too close, but those are easy to
    spot.
    [Hello.PcbLib]
2013-11-12 testpoint updated
    pin number removed
    [Hello.SchLib]
2013-11-13 backup commit before installing bootcamp
    [Base Station.PcbDoc, Base Station.PrjPcb, Base Station.SchDoc, Base Station_test.PcbDoc, Coil_Control.SchDoc, Current_Sensing.SchDoc, LEDs.SchDoc, Power_Control.SchDoc]
2013-11-14 final changes to EVT1 plus zip file for fabrication
    [Base Station.PcbDoc, Base Station.SchDoc, Coil_Control.SchDoc, Current_Sensing.SchDoc, LEDs.SchDoc, Power_Control.SchDoc, Wireless_Power_Controller.SchDoc]
2013-11-14 pcb was not saved, sorry
    [Base Station.PrjPcb]
2013-11-19 blind vias eliminated, r19 added, layout revised
    [Base Station.PcbDoc, Base Station.PrjPcb, Base Station.SchDoc, Coil_Control.SchDoc, Current_Sensing.SchDoc, LEDs.SchDoc, Power_Control.SchDoc, Snooze_Control.SchDoc]
2013-11-20 Y08560R50000D9W resistor added
    [Hello.PcbLib, Hello.SchLib]
2013-11-21 Y11192R00000D9W resistor added
    [Hello.PcbLib, Hello.SchLib]
2013-11-21 current sensing traces changed after TI review
    probably unnecessary
    [Base Station.PcbDoc, Base Station.PrjPcb]
2013-11-21 Y160710R0000D9W resistor added
    [Hello.PcbLib, Hello.SchLib]
2013-11-21 2-1614884-8 resistor added, along with high density 0805 footprint
    [Hello.PcbLib, Hello.SchLib]
2013-11-21 ERA-6ARB302V resistor added
    [Hello.SchLib]
2013-11-21 PNM0805E5001BST5 resistor added
    [Hello.SchLib]
2013-11-21 MAX9934T/F added, along with uMAX8 footprint
    [Hello.PcbLib, Hello.SchLib]
2013-11-22 ADS1256 added together with SOIC-28
    [Hello.PcbLib, Hello.SchLib]
2013-11-22 RES0805 updated, RES0603 added
    [Hello.PcbLib]
2013-11-22 RES0402 added
    [Hello.PcbLib]
2013-11-22 RES0201 added
    [Hello.PcbLib]
2013-11-22 RES01005 added
    [Hello.PcbLib]
2013-11-22 RES1206 added
    [Hello.PcbLib]
2013-11-22 RES1210 added. RES1206 updated
    [Hello.PcbLib]
2013-11-22 RES1812 added
    [Hello.PcbLib]
2013-11-22 RES2512 added
    [Hello.PcbLib]
2013-11-22 ERA-2AED103X resistor added
    [Hello.SchLib]
2013-11-22 ERJ-1GEF1002C resistor added
    [Hello.SchLib]
2013-11-22 ERJ-1GEJ104C resistor added.
    "Value" field added to several other resistors
    [Hello.SchLib]
2013-11-22 ERA-2AED181X resistor added
    [Hello.SchLib]
2013-11-22 ERA-2AEB2321X resistor added
    [Hello.SchLib]
2013-11-22 ERA-2AEB122X resistor added
    [Hello.SchLib]
2013-11-22 ERJ-1GEF4702C resistor added
    [Hello.SchLib]
2013-11-22 ERJ-1GEF4872C resistor added
    [Hello.SchLib]
2013-11-22 ERJ-1GEF4873C resistor added
    [Hello.SchLib]
2013-11-22 ERJ-1RHD1003C resistor added
    [Hello.SchLib]
2013-11-22 ERA-2AED123X resistor added
    [Hello.SchLib]
2013-11-22 ERJ-1GEJ3R0C resistor added
    [Hello.SchLib]
2013-11-22 ERJ-1GEF2201C resistor added
    [Hello.SchLib]
2013-11-22 UMK105B7104KV-FR capacitor added
    [Hello.SchLib]
2013-11-22 TMK105B7223KV-F capacitor added
    [Hello.SchLib]
2013-11-22 LMK063BJ104KP-F capacitor added
    [Hello.SchLib]
2013-11-22 UMK063CG270JT-F capacitor added
    [Hello.SchLib]
2013-11-22 TMK063B7102KP-F capacitor added
    [Hello.SchLib]
2013-11-22 EMK105SD222JV-F capacitor added
    [Hello.SchLib]
2013-11-22 EMK105B7473KV-F capacitor added
    [Hello.SchLib]
2013-11-23 C2012JB1E106K085AC capacitor added and CAP0805 footprint
    [Hello.PcbLib, Hello.SchLib]
2013-11-23 C1005X7R1H473K050BB capacitor added
    [Hello.SchLib]
2013-11-23 CGA2B3X7R1H683K050BD capacitor added
    [Hello.SchLib]
2013-11-23 C0603C0G1E180G030BG capacitor added
    [Hello.SchLib]
2013-11-23 GRM155R71H182KA01D capacitor added
    [Hello.SchLib]
2013-11-23 GRM1535C1H101JDD5D capacitor added
    [Hello.SchLib]
2013-11-23 GRM033R71A103KA01J capacitor added
    [Hello.SchLib]
2013-11-23 GCM0335C1E150JD03D capacitor added
    [Hello.SchLib]
2013-11-23 GRM033R70J103KA01D capacitor added
    [Hello.SchLib]
2013-11-23 CL03A105KQ3CSNC capacitor added
    [Hello.SchLib]
2013-11-25 First stab at via-in-pad (WIP)
    [Band.PcbDoc]
2013-11-25 LLL185C70G225ME01L capacitor added
    [Hello.SchLib]
2013-11-25 JMK063BJ104KP-F capacitor added
    and LMK063BJ104KP-F footprint info updated to the correct 0201
    [Hello.SchLib]
2013-11-25 C1005JB1A475K050BC capacitor added
    [Hello.SchLib]
2013-11-25 C1608X5R0J106K080AB capacitor added
    [Hello.SchLib]
2013-11-25 LMK105BJ474KV-F capacitor added
    [Hello.SchLib]
2013-11-25 UMK107BJ105KA-T capacitor added
    [Hello.SchLib]
2013-11-25 CGJ4J2X7R0J335K125AA capacitor added
    [Hello.SchLib]
2013-11-25 TPCL475K010R5000 cap added
    and CAP0603_POLARIZED footprint added
    [Hello.PcbLib, Hello.SchLib]
2013-11-25 double entry resistor deleted (2.32k)
    [Hello.SchLib]
2013-11-25 ERJ-6GEY0R00V jumper resistor added
    [Hello.SchLib]
2013-11-25 MI0805K601R-10 ferrite bead added
    [Hello.SchLib]
2013-11-25 tantalum caps updated with polarized symbol and refdes
    [Hello.SchLib]
2013-11-26 Y14880R10000B9R resistor added along with footprint
    [Hello.PcbLib, Hello.SchLib]
2013-11-26 Y14880R10000B9R fixed
    it had a double pad
    [Hello.PcbLib]
2013-11-26 Hello Base Station ID Block added
    [Hello.PcbLib]
2013-11-26 all caps and res names updated with footprint info
    [Hello.SchLib]
2013-11-26 base station with CAM data on pcb
    [Base Station.PcbDoc, Base Station.PrjPcb, Base Station.SchDoc, Coil_Control.SchDoc, Current_Sensing.SchDoc, LEDs.SchDoc, Power_Control.SchDoc, Snooze_Control.SchDoc]
2013-11-26 fixed an issue with keepout layer
    [Base Station.PcbDoc]
2013-11-26 ERA-6AEB102V resistor added
    [Hello.SchLib]
2013-11-26 ERA-6AEB202V resistor added
    [Hello.SchLib]
2013-11-27 C27 set as DNP
    [Coil_Control.SchDoc]
2013-11-28 start drawing Band Current Sensing board
    [Band current sensing.PcbDoc, Band current sensing.PrjPCB, Band current sensing.SchDoc, Bluetooth MCU.SchDoc, Current sense.SchDoc, FTDI.SchDoc, GPS.SchDoc, HeartRate.SchDoc]
2013-12-02 SOIC-28 footprint corrected, ADS1282 added
    [Hello.PcbLib, Hello.SchLib]
2013-12-02 ADS1282 pinout updated
    [Hello.SchLib]
2013-12-03 USB4604 added, along with SQFN-48 footprint
    [Hello.PcbLib, Hello.SchLib]
2013-12-03 Add new Island for Wireless Power and move components
    [Band.PrjPCB, Band.SchDoc, Power.SchDoc, Wireless Power.SchDoc]
2013-12-03 Add new Island to PCB and clean up routing and component placement
    [Band.PcbDoc]
2013-12-03 Modifications to BLE / GPS lines
    [Band.PcbDoc]
2013-12-03 refdes for USB_micro_b updated
    it was *, now it's U?
    [Hello.SchLib]
2013-12-04 24 Mhz crystal added along wit footprint
    ABLS-24.000MHZ-B4-T
    [Hello.PcbLib, Hello.SchLib]
2013-12-04 a few sheets added
    USB controller plus various current sensing components
    [Band current sensing.PrjPCB, Band current sensing.SchDoc, Bluetooth MCU.SchDoc, Current sense.SchDoc, Current sensing 1.SchDoc, Current sensing 2.SchDoc, FTDI.SchDoc, GPS.SchDoc]
2013-12-04 Placed pads on IMU Island for battery and coil leads
    [Band.PcbDoc]
2013-12-04 Move Battery and Coil connections to Motion Island
    [Band.SchDoc, Motion.SchDoc, Power.SchDoc, Wireless Power.SchDoc]
2013-12-04 Extend Motion Island and add Battery and Coil connections
    [Band.PcbDoc]
2013-12-04 Test-route a regulator as per datasheet
    [Band.PcbDoc]
2013-12-04 Clear out channel between HRS and LEDs
    [Band.PcbDoc]
2013-12-05 Replace placeholder coil pads with real ones
    [Band.PcbDoc]
2013-12-05 Re-arrange Motion Island to make room for frame locators and connect power
    [Band.PcbDoc]
2013-12-05 Move a testpoint away
    [Band.PcbDoc]
2013-12-05 Add Battery terminals to Wireless Power Island
    [Wireless Power.SchDoc]
2013-12-05 Place Battery pads and partially route Gas Gauge
    [Band.PcbDoc]
2013-12-05 Add SC8252 Dual N-chan Enhancement Mode FET
    [Hello.PcbLib, Hello.SchLib]
2013-12-05 Add SC8252 to Wireless Power Island
    [Wireless Power.SchDoc]
2013-12-05 Add PCM to Wireless Power Island
    [Hello.PcbLib, Hello.SchLib, Wireless Power.SchDoc]
2013-12-05 STM32F427BIT6 uC added
    along with LQFP208 footprint
    [Hello.PcbLib, Hello.SchLib]
2013-12-05 STM32F427ZIT6 uC added
    along with LQFP144 footprint
    [Hello.PcbLib, Hello.SchLib]
2013-12-06 moving ahead on the schematic
    uC added along with a few components and net names
    [Band current sensing.PrjPCB, Bluetooth MCU.SchDoc, Current sensing 1.SchDoc, Current sensing 2.SchDoc, FTDI.SchDoc, GPS.SchDoc, HeartRate.SchDoc, Motion.SchDoc]
2013-12-06 2 files deleted, main sheet updated
    [Band current sensing.SchDoc, Current sense.SchDoc, USB.SchDoc]
2013-12-06 Connect up batteries to the right nets
    [Motion.SchDoc, Wireless Power.SchDoc]
2013-12-06 Fix DFM1616-6 footprint
    [Hello.PcbLib]
2013-12-06 Add stitching to battery lines and place PCM ICs
    [Band.PcbDoc]
2013-12-06 Fix schematic for SC8252
    [Hello.SchLib]
2013-12-06 Update PCM schematic with fixed SC8252 component
    [Wireless Power.SchDoc]
2013-12-06 Add passives for PCM chips
    [Wireless Power.SchDoc]
2013-12-06 Route PCM circuit
    [Band.PcbDoc]
2013-12-06 Establish min via size as 0.1/0.225mm (laser)
    [Band.PcbDoc]
2013-12-06 Fix GPS_nCS net name
    [Band.PcbDoc, Bluetooth MCU.SchDoc, GPS.SchDoc]
2013-12-06 Musical ball-out on BLE MCU for easier routing
    [Band.PcbDoc, Band.SchDoc, Bluetooth MCU.SchDoc]
2013-12-06 Re-add vias for RN4 signals
    [Band.PcbDoc]
2013-12-06 Reduce size of EXB18V footprint
    Suggested by SEP
    [Band.PcbDoc, Hello.PcbLib]
2013-12-06 Switch MCU ball-out for GPS signals and route all GPS signals
    [Band.PcbDoc, Bluetooth MCU.SchDoc]
2013-12-06 VQFN-48 footprint updated with 3d box and orientation dot
    [Hello.PcbLib]
2013-12-06 CSD97376Q4M footprint updated
    orientation dot and 3d box
    [Hello.PcbLib]
2013-12-06 UQFN10 footprint updated
    3d box and orientation dot
    [Hello.PcbLib]
2013-12-06 TLV70033DSE footrpint updated
    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
    [Hello.PcbLib]
2013-12-06 C_0.068u_10_50_X7R_0402cap updated
    with PN C1005X7R1H683K050BB
    [Hello.SchLib]
2013-12-06 C1608JB1E106M080AC cap added
    [Hello.SchLib]
2013-12-06 C_1u_10_6.3_X5R_0402 cap added
    [Hello.SchLib]
2013-12-06 C_10000p_10_6.3_X7R_0402 cap added
    [Hello.SchLib]
2013-12-06 C_15p_5_25_C0G_0201 PN updated
    new PN: GRM0335C1E150JD01D. the old one wasn't available anymore
    [Hello.SchLib]
2013-12-06 C_10000p_10_10_X7R_0201 PN changed
    to one that allows to purchase in 15,000 components lot rather than
    50,000
    [Hello.SchLib]
2013-12-06 C_22n_10_50_X7R_0402 cap added
    [Hello.SchLib]
2013-12-06 R_10k_5_0.05_0201 res added
    [Hello.SchLib]
2013-12-06 C_1u_10_10_X5R_0201 cap added
    [Hello.SchLib]
2013-12-06 previous cap was added by mistake, reverting
    [Hello.SchLib]
2013-12-07 First PCB draft for review
    [Band.PcbDoc]
2013-12-07 Normalize designator font size
    [Band.PcbDoc]
2013-12-07 Update PCB Documentation
    [Band.PcbDoc]
2013-12-07 replacing generic caps and res with the new components in library
    [Bluetooth MCU.SchDoc, GPS.SchDoc, HeartRate.SchDoc, Motion.SchDoc, Power.SchDoc, Storage.SchDoc, Vibe.SchDoc, Wireless Power.SchDoc]
2013-12-07 Mirror regulator keepouts
    [Band.PcbDoc]
2013-12-07 Modify M310210 component for closer edge placement and easier routing
    [Hello.PcbLib]
2013-12-07 Another change to M310210 for matching cap clearance
    [Hello.PcbLib]
2013-12-07 Fix disconnected AC2 net
    [Wireless Power.SchDoc]
2013-12-07 Add Raw_HRS_Signal connect between HRS and BLE. Shuffle BLE ball-out.
    [Band.SchDoc, Bluetooth MCU.SchDoc, HeartRate.SchDoc]
2013-12-07 Move antennas slightly to left to make room for GND plane on right side
    Also implement Raw_HRS_Signal routing and tweak routing
    [Band.PcbDoc]
2013-12-07 Switch NOR WP# line to pull-down from pull-up
    [Band.PcbDoc, Storage.SchDoc]
2013-12-07 Fix R5405 pin assignments
    [Hello.SchLib, Wireless Power.SchDoc]
2013-12-07 Remove via from DFN1616-6 footprint
    [Hello.PcbLib]
2013-12-07 Re-layout PCM after changes to R5405 part
    [Band.PcbDoc]
2013-12-07 Now with useful and aligned BLE Island Test Points
    [Band.PcbDoc, Bluetooth MCU.SchDoc]
2013-12-07 Separate TP's on Storage Schematic
    [Storage.SchDoc]
2013-12-07 Fix up board dimensioning
    [Band.PcbDoc]
2013-12-07 Remove un-usable HRS TP's
    [HeartRate.SchDoc]
2013-12-07 Add TP's to Power Island
    [Band.PcbDoc, Power.SchDoc]
2013-12-07 Fix GPS Signal Inductor footprint size
    [Band.PcbDoc, GPS.SchDoc]
2013-12-07 Add TP's to Vibe Island
    [Band.PcbDoc, Vibe.SchDoc]
2013-12-07 Add TP's to Wireless Power Island
    [Band.PcbDoc, Wireless Power.SchDoc]
2013-12-07 Add TP
    [Band.PcbDoc, GPS.SchDoc]
2013-12-07 Add IMU Island TP's
    [Band.PcbDoc]
2013-12-07 Update Project block to EVT3
    [Band.PcbDoc, Hello.PcbLib]
2013-12-09 R_2k_1_0.05_0201 resistor added
    [Hello.SchLib]
2013-12-09 R_220_1_0.05_0201 resistor added
    [Hello.SchLib]
2013-12-09 R_42.2k_0.1_0.063_0402 res added
    [Hello.SchLib]
2013-12-09 R31, R32, R25 defined by dedicated components
    [Wireless Power.SchDoc]
2013-12-09 latest change not committed
    [Wireless Power.SchDoc]
2013-12-10 REF5045 added along with SOIC-8_0.65 footprint
    4.5 reference voltage
    [Hello.PcbLib, Hello.SchLib]
2013-12-10 C_10u_20_20_3528_Tant capacitor added
    and Tant_EIA3528 footprint
    [Hello.PcbLib, Hello.SchLib]
2013-12-10 C_10000p_1_25_NP0_0603 cap added
    [Hello.SchLib]
2013-12-10 C_2.2u_10_20_3528_Tant added
    [Hello.SchLib]
2013-12-10 STM32F427ZIT6 power pins updated
    [Hello.SchLib, uC.SchDoc]
2013-12-10 Tant_EIA_6032 footprint added
    and C_100u_10_16_6032_Tant cap added
    [Hello.PcbLib, Hello.SchLib]
2013-12-10 ABLS2-4.096MHZ-D4Y-T crystal added
    and footprint info updated on the 24MHz crystal
    [Hello.SchLib]
2013-12-10 C_27p_2_25_NP0_0201 added
    [Hello.SchLib]
2013-12-10 CB3XX_oscillator footprint added
    and Osc_160M_HCMOS,TTL_3.3_50_60m schem symbol
    [Hello.PcbLib, Hello.SchLib]
2013-12-11 TE-2040343 footprint update
    component centered on pin 3 and 3d box added
    [Hello.PcbLib]
2013-12-11 end of day commit
    removing temporary base stations pcb
    [ADC Reference voltage.SchDoc, ADC.SchDoc, ADC1.SchDoc, ADC2.SchDoc, ADC3.SchDoc, ADC4.SchDoc, ADC5.SchDoc, Band current sensing.PrjPCB]
2013-12-11 Enlarge AC1 and AC2 traces from 0.2mm to 0.6mm
    [Band.PcbDoc]
2013-12-11 Normalize designator height
    [Band.PcbDoc]
2013-12-11 Minor via adjustments
    [Band.PcbDoc]
2013-12-11 Move cap on HRS for frame clearance
    [Band.PcbDoc]
2013-12-11 Move another cap for HRS frame clearance
    [Band.PcbDoc]
2013-12-11 getting ready for integrating the current sensing system to the new band schematic
    [ADC Reference voltage.SchDoc, ADC1.SchDoc, ADC2.SchDoc, ADC3.SchDoc, ADC4.SchDoc, ADC5.SchDoc, Band current sensing.PrjPCB, Bluetooth MCU.SchDoc]
2013-12-12 REF5045 had an extra pin, removed
    [Hello.SchLib]
2013-12-12 a few signals on the USB4604 are active low
    graphics now reflect the active low behavior
    [Hello.SchLib]
2013-12-12 Add pull-up to GG_SDA
    [Wireless Power.SchDoc]
2013-12-12 Add R33 and add a few more GND vias
    [Band.PcbDoc]
2013-12-12 Fixup Bottom Overlay
    [Band.PcbDoc]
2013-12-12 Fix Top Overlay
    [Band.PcbDoc]
2013-12-12 Change Band Room to keep-out
    [Band.PcbDoc]
2013-12-12 Re-add ground pours, fix 50-ohm instruction
    [Band.PcbDoc]
2013-12-12 Update C25 to 22uF, 10V
    As per James Blanc recommendations for 3v3 Regulator PWM mode stability.
    [Power.SchDoc]
2013-12-12 Add C1608JB1A226M080AC component
    [Hello.SchLib]
2013-12-12 Update C25 to an actual component for that actual cap
    [Power.SchDoc]
2013-12-12 fix adc connections, starting to work on ulpi usb stuff
    [ADC Reference voltage.SchDoc, ADC1.SchDoc, ADC2.SchDoc, ADC3.SchDoc, ADC4.SchDoc, ADC5.SchDoc, ADC_CLK.SchDoc, Band current sensing.PrjPCB]
2013-12-12 added PN for new C20
    still need to create the new component in the library
    [Motion.SchDoc]
2013-12-12 renamed 2 pins on STM32F427ZIT6
    to make clear that they have additional functionality
    [Hello.SchLib]
2013-12-12 USB3315 added
    QFN-24_0.5 footprint added too
    [Hello.PcbLib, Hello.SchLib]
2013-12-12 default comment updated on USB3315
    [Hello.SchLib]
2013-12-13 cortex debug connector added
    along with footprint
    [Hello.PcbLib, Hello.SchLib]
2013-12-13 G3T22 toggle switch added
    along with its footprint
    [Hello.PcbLib, Hello.SchLib]
2013-12-13 Add polygon cutouts to remove ground stubs
    [Band.PcbDoc]
2013-12-14 Increase MPU-6500 footprint pad widths by 0.0286mm
    By Jabil recommendation
    [Band.PcbDoc]
2013-12-14 Save as prev but for component library
    [Hello.PcbLib]
2013-12-14 Create Fiducial component
    [Hello.PcbLib, Hello.SchLib]
2013-12-14 Add 3 fiducials to each top and bottom layers
    [HeartRate.SchDoc, Motion.SchDoc, Storage.SchDoc, Vibe.SchDoc]
2013-12-14 Palce Fiducials on PCB
    [Band.PcbDoc]
2013-12-16 new 8.06k resistor
    [Hello.SchLib]
2013-12-16 update USB3315 with footprint info
    [Hello.SchLib]
2013-12-18 adding connections for USB stuff and JTAG
    [Band current sensing.PrjPCB, Current amplifiers 1.SchDoc, Current sensing system.SchDoc, FTDI.SchDoc, JTAG Control.SchDoc, ULPI wrapper.SchDoc]
2013-12-18 TLV70033DSE updated with correct pinout and footprint
    a mistake in pin assignments caused the first prototype to not work
    [Hello.SchLib]
2013-12-18 TE-2040343 gnd pads extended
    [Hello.PcbLib]
2013-12-18 BQ500212A pin 13 name fixed
    PN and vendor info added
    [Hello.SchLib]
2013-12-18 BQ500212A actually fixed now
    [Hello.SchLib]
2013-12-18 SOT-323 and SOT-23 updated with 3d body
    BAT54 diodes footprint info updated
    [Hello.PcbLib, Hello.SchLib, Wireless_Power_Controller.SchDoc]
2013-12-18 C_4.7u_10_10_X5R_0805 cap added
    [Hello.SchLib]
2013-12-18 NET_TIE footprint is now completely covered by soldermask
    [Hello.PcbLib]
2013-12-18 C_1u_10_16_X7R_0603 cap added
    [Hello.SchLib]
2013-12-18 C_4.7u_20_10_0603 added
    [Hello.SchLib]
2013-12-18 C_100u_20_6.3_X5R_1206 added
    along with 1206 footprint
    [Hello.PcbLib, Hello.SchLib]
2013-12-18 C_1u_10_16_X5R_0603 added
    [Hello.SchLib]
2013-12-18 C_0.1u_10_50_X7R_0603 added
    [Hello.SchLib]
2013-12-18 C_2.2u_10_10_X7R_0603 added
    [Hello.SchLib]
2013-12-18 C_22u_10_25_X5R_1210 added
    along with CAP1210 footprint
    [Hello.PcbLib, Hello.SchLib]
2013-12-18 C_22u_10_25_X5R_1210 PN updated
    [Base Station.PcbDoc, Coil_Control.SchDoc, Current_Sensing.SchDoc, Hello.SchLib, LEDs.SchDoc, Snooze_Control.SchDoc, Wireless_Power_Controller.SchDoc]
2013-12-18 C_10000p_10_50_X7R_0603 added
    [Hello.SchLib]
2013-12-18 C_4.7u_20_10_X5R_0603 updated with temp coefficient in the name
    [Hello.SchLib]
2013-12-18 R_1k_1_0.1_0402 added
    [Hello.SchLib]
2013-12-18 R_2M_1_0.1_0603 added
    [Hello.SchLib]
2013-12-18 INA199A1RSW added
    was originally INA199A1RSW, and lead to layout issues
    [Hello.SchLib]
2013-12-19 R_0.02_1_0.5_0805 added
    [Hello.SchLib]
2013-12-19 R_10_1_0.1_0402 added
    [Hello.SchLib]
2013-12-19 C_10u_10_10_X5R_1210 added
    [Hello.SchLib]
2013-12-19 C_0.1u_10_100_X7R_1206 added
    [Hello.SchLib]
2013-12-19 C_0.1u_10_50_NP0_1210 added
    [Hello.SchLib]
2013-12-19 R_12.1k_1_0.1_0402 added
    [Hello.SchLib]
2013-12-19 C_4700p_5_50_NP0_0603 added
    [Hello.SchLib]
2013-12-19 R_100k_1_0.1_0402 added
    [Hello.SchLib]
2013-12-19 R_10k_1_0.1_0402 added
    [Hello.SchLib]
2013-12-19 C_33p_5_50_NP0_0603 added
    [Hello.SchLib]
2013-12-20 R_523k_1_0.1_0402 added
    [Hello.SchLib]
2013-12-20 NSVBAT54WT1G added, in place of BAT54
    [Hello.SchLib]
2013-12-20 DTC114EMT2L added
    and relative footprint
    [Hello.PcbLib, Hello.SchLib]
2013-12-20 R_475_1_0.1_0402 added
    [Hello.SchLib]
2013-12-20 Embiggened an AC2 trace connecting the Pad to the line
    [Band.PcbDoc]
2013-12-20 Fix C25 value to match part number at 22uF
    [Power.SchDoc]
2013-12-27 Add alternate footprint for M310210
    Use polygon cutouts instead of keepouts to help with copper pullback
    [Hello.PcbLib, Hello.SchLib]
2013-12-27 Add alternate footprint for M830110
    use polygon cutouts instead of keepouts to aid in copper pullback
    [Hello.PcbLib, Hello.SchLib]
2013-12-27 Update schematics to use new antenna footprints
    [Bluetooth MCU.SchDoc, GPS.SchDoc]
2013-12-27 Incorporate 0.2mm copper pullback from board edge and rigid/flex transition
    Fix stray ground spurs
    Change chip antenna footprints to use polygon cutouts instead of
    keepouts to facilitate pullback
    [Band.PcbDoc]
2013-12-28 Enlarge bq51050b ball lands to 0.25mm diameter
    [Hello.PcbLib]
2013-12-28 Import ball diameter changes for GSD4e and bq51050b ICs
    [Band.PcbDoc]
2013-12-28 Enlarge GSD4e ball land size to 0.30mm
    [Hello.PcbLib]
2013-12-28 Swap Gauge_Int and RXD pinouts to facilitate testpoint alignment
    [Bluetooth MCU.SchDoc]
2013-12-28 Enlarge power traces. Align testpoints on BLE Island
    [Band.PcbDoc]
2013-12-28 Fix minimum trace size and enlarge 0.07mm traces to 0.1mm
    [Band.PcbDoc]
2014-01-01 first commit for rev2
    [Base Station.PrjPcb, Base Station.SchDoc, Coil_Control.SchDoc, Current_Sensing.SchDoc, LEDs.SchDoc, Power_Control.SchDoc, Snooze_Control.SchDoc, Wireless_Power_Controller.SchDoc]
2014-01-01 R_76.8k_1_0.1_0402 added
    [Hello.SchLib]
2014-01-01 R_3.6k_1_0.1_0402 added
    [Hello.SchLib]
2014-01-01 R_48.7k_1_0.1_0402 added
    [Hello.SchLib]
2014-01-01 R_56.2k_1_0.1_0402 added
    [Hello.SchLib]
2014-01-01 R_86.6k_1_0.1_0402 added
    [Hello.SchLib]
2014-01-01 All base station schematic updated with new library components
    from now on, working on fixing flaws and/or adding new features
    [Base Station.PrjPcb, Base Station.SchDoc, Coil_Control.SchDoc, Current_Sensing.SchDoc, LEDs.SchDoc, Power_Control.SchDoc, Snooze_Control.SchDoc, Wireless_Power_Controller.SchDoc]
2014-01-02 TLV70033DSE pin type updated
    [Hello.SchLib]
2014-01-02 R_10_5_1_2512 added
    [Hello.SchLib]
2014-01-02 R_22_5_0.125_0805 added
    [Hello.SchLib]
2014-01-02 VQFN-48 info updated, C_2.2u_10_16_X7R_1206 added
    [Hello.PcbLib, Hello.SchLib]
2014-01-03 TE-2040343 micro-USB connector modified to avoid DRC errors
    [Hello.PcbLib]
2014-01-03 first shot at base station rev2
    [Base Station.PcbDoc]
2014-01-03 commit before vacation
    [Base Station r1.PcbDoc, Base Station.PcbDoc, Base Station.PrjPcb, Base Station.SchDoc, Coil_Control.SchDoc, Current_Sensing.SchDoc, LEDs.SchDoc, Power_Control.SchDoc]
2014-01-15 net tie footprint increased to 1mm trace wide
    [Hello.PcbLib]
2014-01-15 C_4700p_10_50_X7R_0603 added
    [Hello.SchLib]
2014-01-15 HOLE_ROUND_0.6mm added
    [Hello.PcbLib]
2014-01-16 QFN-33_5x5mm added
    [Hello.PcbLib]
2014-01-16 MINI51ZAN added
    [Hello.SchLib]
2014-01-16 PLCC4 footprint added
    [Hello.PcbLib]
2014-01-16 SMLP36RGB2W3 LED added
    [Hello.SchLib]
2014-01-16 corrected PN for last added part: CLVBA-FKA-CAEDH8BBB7A363
    [Hello.SchLib]
2014-01-16 R_100_1_0.1_0402 added
    [Hello.SchLib]
2014-01-16 R_150_1_0.1_0402 added
    [Hello.SchLib]
2014-01-16 Crystal_12M_50_30_18_50 added
    [Hello.SchLib]
2014-01-17 MINI51ZAN pinout updated
    [Hello.SchLib]
2014-01-17 added uC sheet and RGB LEDs
    [Base Station.PcbDoc, Base Station.PrjPcb, Base Station.SchDoc, Coil_Control.SchDoc, Current_Sensing.SchDoc, LEDs.SchDoc, Power_Control.SchDoc, Wireless_Power_Controller.SchDoc]
2014-01-17 R_100k_1_0.05_0201 added
    [Hello.SchLib]
2014-01-17 R_475_1_0.05_0201 added
    [Hello.SchLib]
2014-01-17 R_523k_1_0.05_0201 added
    [Hello.SchLib]
2014-01-17 R_56.2k_1_0.05_0201 added
    [Hello.SchLib]
2014-01-17 R_86.6k_1_0.05_0201 added
    [Hello.SchLib]
2014-01-18 1PS79SB31 and SOD-523 added
    [Hello.PcbLib, Hello.SchLib]
2014-01-18 last symbol updated and footprint pads re-numbered
    [Hello.PcbLib, Hello.SchLib]
2014-01-18 corrected pin number on HOLE_ROUND_0.6MM
    [Hello.PcbLib]
2014-01-18 added pad on QFN-33_5x5mm
    [Hello.PcbLib]
2014-01-19 1PS79SB31 had issues. deleted and re-added
    [Hello.SchLib]
2014-01-19 TXC_7S_crystal added together with Crystal_12M_30_30_12_200
    [Hello.PcbLib, Hello.SchLib]
2014-01-20 Add AD4505-2 and TSL13PFN textures
    [Hello.PcbLib]
2014-01-20 Crystal_12M_30_30_12_200 re-added to avoid sync problems
    [Hello.SchLib]
2014-01-21 component placement almost completed. playing around with polygon pours
    removed unnecessary headers
    [Base Station.PcbDoc, Base Station.PrjPcb, Base Station.SchDoc, Coil_Control.SchDoc, Current_Sensing.SchDoc, LEDs.SchDoc, Power_Control.SchDoc, Snooze_Control.SchDoc]
2014-01-21 board edge radius down from 8 to 6 mm
    minor changes in scheamatic
    [Base Station.PcbDoc, LEDs.SchDoc, Power_Control.SchDoc, Wireless_Power_Controller.SchDoc, uC.SchDoc]
2014-01-22 PCB squeezed further by another 2mm. Layout started
    [Base Station.PcbDoc]
2014-01-22 TL3700AF160QG pushbutton added with its footprint
    [Base Station.SchDoc, Hello.PcbLib, Hello.SchLib]
2014-01-22 Tantalum cap footprints silkscreen updated
    instead of a dot I put a bar to mark the positive contact
    [Hello.PcbLib]
2014-01-23 ALS sheet added, keep moving on the layout
    [ALS.SchDoc, Base Station.PcbDoc, Base Station.PrjPcb, Base Station.SchDoc, Coil_Control.SchDoc, Current_Sensing.SchDoc, LEDs.SchDoc, Power_Control.SchDoc]
2014-01-23 TE-2040343 footprint update
    lateral pads assigned to same net as pin 5
    [Hello.PcbLib]
2014-01-24 routing almost completed
    [Base Station.PcbDoc]
2014-01-24 TP_1.6mm added with its footprint
    [Hello.PcbLib, Hello.SchLib]
2014-01-24 Many components updated with new reference
    Reference was centered on the component rather than on pad #1
    [Hello.PcbLib]
2014-01-24 MKL05Z8VFM4 power pinout corrected
    [Hello.SchLib]
2014-01-24 C_12p_5_25_C0G_0201 added
    [Hello.SchLib]
2014-01-24 Crystal_48M_20_20_8_100 added with ABM12 footprint
    [Hello.PcbLib]
2014-01-24 end of the week commit. new uC added to schematic, plus testpoints for pogo pins
    [ALS.SchDoc, Base Station.PcbDoc, Base Station.SchDoc, Hello.SchLib, LEDs.SchDoc, Power_Control.SchDoc, Wireless_Power_Controller.SchDoc, uC.SchDoc]
2014-01-28 BH1603FVC ALS IC added
    [Hello.PcbLib, Hello.SchLib]
2014-01-29 R_68_5_0.1_0402 added
    [Hello.SchLib]
2014-01-29 R_1.5k_5_0.1_0402 added
    [Hello.SchLib]
2014-01-30 SI4501DY-T1-E3 added
    [Hello.SchLib]
2014-01-31 MKL05Z8VFM4 updated with pin 33
    [Hello.SchLib]
2014-02-04 closing down on base station rev2 (or EVT2, TBD)
    [ALS.SchDoc, Base Station.PcbDoc, Base Station.SchDoc, Coil_Control.SchDoc, Current_Sensing.SchDoc, LEDs.SchDoc, Power_Control.SchDoc, Snooze_Control.SchDoc]
2014-02-04 re-thinking USB connections, power selector and UART lines
    [ADC Reference voltage.SchDoc, ADC1.SchDoc, ADC2.SchDoc, ADC3.SchDoc, ADC4.SchDoc, ADC5.SchDoc, ADC_CLK.SchDoc, Band current sensing.PrjPCB]
2014-02-05 layout done (for now). a few TP removed
    [Base Station.PcbDoc, Base Station.SchDoc, Coil_Control.SchDoc, LEDs.SchDoc, Power_Control.SchDoc, uC.SchDoc]
2014-02-05 pin names updated on MKL05Z8VFM4
    [Hello.SchLib]
2014-02-05 R_33_5_0.1_0402 added
    [Hello.SchLib]
2014-02-05 R_270_5_0.1_0402 added
    [Hello.SchLib]
2014-02-05 R_2k_5_0.5_0805 added
    [Hello.SchLib]
2014-02-06 C_6.8p_0.25_25_C0G_0201 added
    [Hello.SchLib]
2014-02-06 fixed signal names, removed TPs, grounded NC pins, fixed USB FS pull-up, changed headers pitch, changed LED resistors, populate ALS
    fixed crystal caps
    [ALS.SchDoc, Base Station.PcbDoc, Base Station.PrjPcb, Base Station.SchDoc, Coil_Control.SchDoc, Current_Sensing.SchDoc, LEDs.SchDoc, Power_Control.SchDoc]
2014-02-08 Net tie updated to have a better connection
    [Hello.PcbLib]
2014-02-08 last layout revision
    [Base Station.PcbDoc, Current_Sensing.SchDoc]
2014-02-09 REF5030IDGKT added
    [Hello.SchLib]
2014-02-09 R_49.9k_1_0.05_0201 added
    [Hello.SchLib]
2014-02-09 STM32F427ZIT6 pinout corrected
    [Hello.SchLib]
2014-02-10 little change on VIN line
    [Base Station.PcbDoc, Base Station.PrjPcb]
2014-02-10 R_0_jumper_0.25_0603 added
    [Hello.SchLib]
2014-02-10 moving ahead on dev board, adding schematic conncetions for uC, fixing Vref
    [ADC Reference voltage.SchDoc, ADC1.SchDoc, ADC2.SchDoc, ADC3.SchDoc, ADC4.SchDoc, ADC5.SchDoc, Band current sensing.PrjPCB, Band current sensing.xlsx]
2014-02-10 TL3700AF160QG and BH1603FVC footprints update with polygon cutout
    [Hello.PcbLib]
2014-02-11 C_0.1u_5_50_C0G_1206 added
    [Hello.SchLib]
2014-02-11 changes after meeting: clean up traces, add R57, 3.3V TP on the bottom, move traces from mounting holes
    [Base Station.PcbDoc, Coil_Control.SchDoc, Power_Control.SchDoc]
2014-02-11 ES6 footprint updated with pin1 marker
    [Hello.PcbLib]
2014-02-12 routing improved
    [Base Station.PcbDoc]
2014-02-14 C18 and U6 moved to make room for ID
    [ALS.SchDoc, Base Station.PcbDoc, Base Station.PrjPcb, Base Station.SchDoc, Coil_Control.SchDoc, Current_Sensing.SchDoc, LEDs.SchDoc, Power_Control.SchDoc]
2014-02-17 NET TIE soldermask removed. uUSB connector keepout updated
    [Hello.PcbLib]
2014-02-17 change all vias to allow bigger annular ring. reroute a bit
    [Base Station.PcbDoc]
2014-02-18 FCI_10103593-0001LF added
    [Hello.PcbLib]
2014-02-18 FCI USB connector edited and symbol added
    [Hello.PcbLib, Hello.SchLib]
2014-02-18 HOLE_ROUND_3.1mm added
    [Hello.PcbLib]
2014-02-19 holes down to 3.1mm
    [Base Station.PcbDoc, Base Station.PrjPcb, Base Station.SchDoc, Hello.PcbLib, Power_Control.SchDoc]
2014-02-19 3.3V TP moved to avoid via in pad
    [Base Station.PcbDoc]
2014-02-19 SFH7050 added. both symbol and footprint
    [Hello.PcbLib, Hello.SchLib]
2014-02-21 Band dev board schematic closer to review
    [ADC Reference voltage.SchDoc, ADC1.SchDoc, ADC2.SchDoc, ADC3.SchDoc, ADC4.SchDoc, ADC5.SchDoc, ADC_CLK.SchDoc, Band Dev.SchDoc]
2014-02-21 fixed STM32F427ZIT6 pinout
    [Band Dev.SchDoc, Band current sensing.PrjPCB, Current amplifiers 2.SchDoc, Current sensing system.SchDoc, Dev Board Power Control.SchDoc, Development board.SchDoc, FTDI.SchDoc, Hello.SchLib]
2014-02-22 first commit without errors. details to figure out
    [ADC Reference voltage.SchDoc, ADC1.SchDoc, ADC2.SchDoc, ADC3.SchDoc, ADC4.SchDoc, ADC5.SchDoc, ADC_CLK.SchDoc, Band Dev.SchDoc]
2014-02-26 Crystal_32.768k_-_10_12.5_50k added along with ABS25 footprint
    [Hello.PcbLib, Hello.SchLib]
2014-02-26 CPH3448-TL-H added along with CPH3 footprint
    [Hello.PcbLib, Hello.SchLib]
2014-02-27 TP_0.875x0.5mm added, same as 5016
    [Hello.SchLib]
2014-02-27 TP commited now
    [Hello.SchLib]
2014-02-27 AT45DB011D flash memory added
    [Hello.SchLib]
2014-03-01 rearranged ADC inputs, additional UART from FTSI hcip, reset and programming buttons for uC
    [ADC1.SchDoc, ADC2.SchDoc, ADC3.SchDoc, ADC4.SchDoc, ADC5.SchDoc, Band Dev.SchDoc, Band current sensing.PrjPCB, Bluetooth MCU Dev.SchDoc]
2014-03-04 change name to dev board. add control over AD pin for BQ51050
    [ADC Reference voltage.SchDoc, ADC1.SchDoc, ADC2.SchDoc, ADC3.SchDoc, ADC4.SchDoc, ADC5.SchDoc, ADC_CLK.SchDoc, Band Dev.SchDoc]
2014-03-05 change name to Development Board
    [ADC Reference voltage.SchDoc, ADC.SchDoc, ADC1.SchDoc, ADC2.SchDoc, ADC3.SchDoc, ADC4.SchDoc, ADC5.SchDoc, ADC_CLK.SchDoc]
2014-03-10 added a few components info
    [Hello.SchLib]
2014-03-10 PN as default comment for coil drivers
    [Hello.SchLib]
2014-04-01 Added SHT2x sensor from sensirion
    [Hello.PcbLib, Hello.SchLib]
2014-04-16 new Morpheus project. Added Si1145 sensor and its footprint
    [Hello.PcbLib, Hello.SchLib, Morpheus.PrjPcb]
2014-04-16 INMP441 microphone added with its footprint
    [Hello.PcbLib, Hello.SchLib]
2014-04-16 Si114x footprint updated with position dot
    [Hello.PcbLib]
2014-04-16 TPS63061DSC added with its footprint
    [Hello.PcbLib, Hello.SchLib]
2014-04-17 TPS62125 and its footprint added
    [Hello.PcbLib, Hello.SchLib]
2014-04-17 SOT-23-8 footrpint and TPS62120DCN added. starting Morpheus schematic
    [Hello.PcbLib, Hello.SchLib, Morpheus_top_sheet.SchDoc, Power_management.SchDoc]
2014-04-17 C_10u_20_10_X5R_1206 added
    [Hello.SchLib]
2014-04-17 C_10u_20_6.3_X5R_1206 added
    [Hello.SchLib]
2014-04-17 L_15u_20_28_0.24_0.92_1.4 added with SDR0403-xxxxL footprint
    [Hello.PcbLib, Hello.SchLib]
2014-04-18 L_1u_20_?_0.059_1.94_1.68 added with EPL2014 footprint
    [Hello.PcbLib, Hello.SchLib]
2014-04-18 C_47u_20_10_X5R_0805 and C_0.1u_10_50_X7R_0805 added
    [Hello.SchLib]
2014-04-18 R_1M_5_0.125_0805 added
    [Hello.SchLib]
2014-04-18 R_100k_5_0.125_0805 added
    [Hello.SchLib]
2014-04-18 R_1.8M_5_0.125_0805 added
    [Hello.SchLib]
2014-04-18 R_576k_1_0.125_0805 added
    [Hello.SchLib]
2014-04-18 C_22p_5_50_C0G_0805 added
    [Hello.SchLib]
2014-04-18 R_240k_5_0.125_0805 added
    [Hello.SchLib]
2014-04-18 R_301k_1_0.125_0805 added
    [Hello.SchLib]
2014-04-18 C_4.7u_20_6.3_X5R_0603 added
    [Hello.SchLib]
2014-04-18 L_22u_10_10_1_0.105_? added with NLVF25 footprint
    [Hello.PcbLib, Hello.SchLib]
2014-04-21 INMP421 added
    [Hello.PcbLib, Hello.SchLib]
2014-04-21 first stab at Morpheus EVT1 schematic
    [ALS.SchDoc, Bluetooth_MCU.SchDoc, M4F_MCU.SchDoc, Microphone.SchDoc, Morpheus.PrjPcb, Power_management.SchDoc, Temperature_humidity.SchDoc]
2014-04-21 black hook test point added
    [Hello.PcbLib, Hello.SchLib]
2014-04-21 TestPoint_turret_0.093 added
    [Hello.PcbLib, Hello.SchLib]
2014-04-21 MP33AB01H added
    [Hello.PcbLib, Hello.SchLib]
2014-04-21 C_1u_10_6.3_X7R_0805 added
    [Hello.SchLib]
2014-04-21 C_1000p_10_10_X7R_0805 added
    [Hello.SchLib]
2014-04-21 MCP6001 updated
    [Hello.SchLib]
2014-04-21 HTU21D added
    [Hello.PcbLib, Hello.SchLib]
2014-04-22 TSL4531 added
    [Hello.PcbLib, Hello.SchLib]
2014-04-22 Si1141 added
    [Hello.SchLib]
2014-04-22 keep adding stuff to Morpheus EVT: Microphone, poximity, ALS, T/H, Power regulators and BLE
    [ALS.SchDoc, Air_quality.SchDoc, Microphone.SchDoc, Morpheus.PrjPcb, Morpheus_top_sheet.SchDoc, Power_management.SchDoc, Proximity.SchDoc, Temperature_humidity.SchDoc]
2014-04-22 SFH4650 added
    [Hello.PcbLib, Hello.SchLib]
2014-04-22 WLCSP-120_0.4 and MK20DN512AB10R added
    [Hello.PcbLib, Hello.SchLib]
2014-04-23 VCNL4000 added
    [Hello.PcbLib, Hello.SchLib]
2014-04-24 LP5907MFX-3.3 added with SOT-23-5
    [Hello.PcbLib, Hello.SchLib]
2014-04-24 LM3673TL-1.8 and DSGB-5 added
    [Hello.PcbLib, Hello.SchLib]
2014-04-24 L_10u_20_?_0.468_0.68_0.48 added with IND_1007
    [Hello.PcbLib, Hello.SchLib]
2014-04-24 TS332IDT added
    [Hello.SchLib]
2014-04-25 S6B-ZR-SM4A-TF (LF)(SN)(P) added woth GP2Y1010
    [Hello.PcbLib, Hello.SchLib]
2014-04-25 wrong commit, try again
    [Hello.PcbLib, Hello.SchLib]
2014-04-28 R_150_5_0.125_0805 added
    [Hello.SchLib]
2014-04-28 C_220u_20_10_3528_Tant added
    [Hello.SchLib]
2014-04-28 MX25U12835F updated with vendor and pn info
    [Hello.SchLib]
2014-04-29 R_10k_5_0.125_0805 added
    [Hello.SchLib]
2014-04-30 sensor sheets ready
    [ALS.SchDoc, Air_quality.SchDoc, Bluetooth_MCU.SchDoc, M4F_MCU.SchDoc, Microphone.SchDoc, Morpheus.PrjPcb, Morpheus_top_sheet.SchDoc, Power_management.SchDoc]
2014-05-01 FB_1k_3_0.06_1810 and RES1810 added
    [Hello.PcbLib, Hello.SchLib]
2014-05-01 rearranging Morpheus in 3 separate PCBs
    [ALS.SchDoc, Air_quality.SchDoc, Bluetooth_MCU.SchDoc, M4F_MCU.SchDoc, Microphone.SchDoc, Morpheus_bottom.PrjPcb, Morpheus_middle.PrjPcb, Morpheus_top.PrjPcb]
2014-05-01 TLC5940RHB added
    [Hello.SchLib]
2014-05-02 HOLE_ROUND_1.7mm and R_324 added
    [Hello.PcbLib, Hello.SchLib]
2014-05-02 refined schematic for top and bottom boards. starting to shape pcbs
    [ALS.SchDoc, Bluetooth_MCU.SchDoc, LEDs.SchDoc, Microphone.SchDoc, Morpheus_bottom.PcbDoc, Morpheus_bottom.PrjPcb, Morpheus_top.PcbDoc, Morpheus_top.PrjPcb]
2014-05-02 connector update for bryan
    [Microphone.SchDoc, Morpheus_bottom.PcbDoc, Power_management.SchDoc, Temperature_humidity.SchDoc]
2014-05-02 INMP421/441 improved according to datasheet
    [Hello.PcbLib]
2014-05-02 FB_300_2_0.15_0603 added
    [Hello.SchLib]
2014-05-02 wuerth filters added
    [Hello.PcbLib, Hello.SchLib]
2014-05-03 end of week commit, moving forward on top and bottom PCBs
    [ALS.SchDoc, Microphone.SchDoc, Morpheus_bottom.PcbDoc, Morpheus_top.PrjPcb, Morpheus_top.SchDoc, Power_management.SchDoc, Proximity.SchDoc, Speaker.SchDoc]
2014-05-05 FCI_USB_micro_B_10103592 added with footprint
    [Hello.PcbLib, Hello.SchLib]
2014-05-05 Hole added
    [Hello.SchLib]
2014-05-05 nicer hole actually
    [Hello.SchLib]
2014-05-06 GRPB31VWTC-RC header added
    [Hello.PcbLib, Hello.SchLib]
2014-05-06 molex connector 49597-2007 added
    [Hello.PcbLib, Hello.SchLib]
2014-05-06 Cuttable_trace_0.25mm added
    [Hello.PcbLib, Hello.SchLib]
2014-05-07 LM3370SD-4221 added with WSON-16
    [Hello.PcbLib, Hello.SchLib]
2014-05-07 L_2.2u_20_?_0.195_1.05_1.05 added with footprint
    [Hello.PcbLib, Hello.SchLib]
2014-05-08 VCNL4010 added
    [Hello.PcbLib, Hello.SchLib]
2014-05-08 INMP421_broken added to improve routing
    [Hello.PcbLib]
2014-05-08 molex 51281-011 added
    [Hello.PcbLib, Hello.SchLib]
2014-05-08 layout done, but power part needs review. new big connector added
    [ALS.SchDoc, Hello.SchLib, Microphone.SchDoc, Morpheus_bottom.PcbDoc, Morpheus_bottom.PrjPcb, Morpheus_top.PcbDoc, Power_management.SchDoc, Proximity.SchDoc]
2014-05-09 WSON-16 silkscreen modified
    [Hello.PcbLib]
2014-05-09 end of day commit, gotta check mounting holes position
    [Hello.PcbLib, Morpheus_bottom.PcbDoc]
2014-05-09 DRC returned no errors. Cuttable_trace updated
    [Hello.PcbLib, Hello.SchLib, Microphone.SchDoc, Morpheus_bottom.PcbDoc, Morpheus_bottom.PrjPcb, Power_management.SchDoc, Temperature_humidity.SchDoc]
2014-05-10 VCNL4000 deleted and 3020 added
    [Hello.PcbLib, Hello.SchLib]
2014-05-12 removed extra pad from 51281-011
    [Hello.PcbLib]
2014-05-12 PCB shrinked on the top side, routing rearranged
    [Morpheus_bottom.PcbDoc, Morpheus_bottom.PrjPcb, Power_management.SchDoc]
2014-05-12 HDR1X2 and MHDR1X3 added, taken from Altium libraries
    [Hello.PcbLib, Hello.SchLib]
2014-05-13 CAM data added
    [Morpheus_bottom.PcbDoc, Morpheus_bottom.PrjPcb, Power_management.SchDoc]
2014-05-13 CC3200 added
    [Hello.SchLib]
2014-05-13 rearrange files between boards
    [Microphone.SchDoc, Morpheus_bottom.PcbDoc, Morpheus_bottom.PrjPcb, Morpheus_bottom.step, Morpheus_middle.PrjPcb, Morpheus_middle.SchDoc, Morpheus_top.PrjPcb, Power_management.SchDoc]
2014-05-14 changed test point footprints to have more annular ring
    [Hello.PcbLib, Hello.SchLib]
2014-05-15 Crystal_40M_50_50_18_50 added
    [Hello.PcbLib, Hello.SchLib]
2014-05-15 DAC7512 added with SOT-23-6
    [Hello.PcbLib, Hello.SchLib]
2014-05-19 libraries update for ben and beginning-of-week commit
    [40mm board.DXF, 54mm Board.DXF, ALS.SchDoc, Air_quality.SchDoc, Bluetooth_MCU.SchDoc, Flash.SchDoc, Hello.PcbLib, Hello.SchLib]
2014-05-20 C_9p_0.5_16_C0G_0402 and C_1p_0.1_16_C0G_0402 added
    [Hello.PcbLib, Hello.SchLib]
2014-05-20 ILCX19-FB5F18-16.000MHz updated
    [Hello.SchLib]
2014-05-21 52885-0374 and 53647-0374 added
    [Hello.PcbLib, Hello.SchLib]
2014-05-21 R_10_5_0.125_0805 added
    [Hello.SchLib]
2014-05-21 completing GPIO assignment, place key components on top and middle boards, refine boards shapes
    [ALS.SchDoc, Air_quality.SchDoc, Bluetooth_MCU.SchDoc, Flash.SchDoc, M4F_MCU.SchDoc, M4F_MCU_Antennas.SchDoc, M4F_MCU_Power.SchDoc, Morpheus_bottom.PcbDoc]
2014-05-21 added 3 headers
    [Hello.PcbLib, Hello.SchLib]
2014-05-23 UFL connector added
    [Hello.PcbLib, Hello.SchLib]
2014-05-23 UFL symbol added too
    [Hello.SchLib]
2014-05-27 top pcb ready for review. assign gpios on middle board
    [ALS.SchDoc, ALS.SchLib, Air_quality.SchDoc, Bluetooth_MCU.SchDoc, Flash.SchDoc, Hello.PcbLib, M4F_MCU.SchDoc, M4F_MCU_Antennas.SchDoc]
2014-05-28 update after review meeting
    [ALS.SchDoc, Bluetooth_MCU.SchDoc, Morpheus_middle.PcbDoc, Morpheus_top.DWG, Morpheus_top.PcbDoc, Morpheus_top.PrjPcb, Morpheus_top.SchDoc, Morpheus_top.step]
2014-05-28 FIXED 26 pin connector PN
    [Hello.PcbLib, Hello.SchLib, Morpheus_bottom.PcbDoc, Power_management.SchDoc]
2014-05-28 R_1k_5_0.125_0805 added
    [Hello.SchLib]
2014-05-28 R_5k_5_0.125_0805 added
    [Hello.SchLib]
2014-05-28 C_10p_1_50_C0G_0402 added
    [Hello.SchLib]
2014-05-28 C_2.2p_0.05_50_C0G_0402 added
    [Hello.SchLib]
2014-05-28 Johanson_2500AT44M0400E antenna added
    [Hello.PcbLib, Hello.SchLib]
2014-05-28 latest middle board version, ready for review
    [Air_quality.SchDoc, M4F_MCU_Antennas.SchDoc, M4F_MCU_Power.SchDoc, Morpheus_middle.SchDoc, Morpheus_top.DWG, Morpheus_top.PcbDoc, Morpheus_top.PrjPcb, Morpheus_top.step]
2014-05-29 releasing middle pcb fro Dyke, latest mods.
    [Air_quality.SchDoc, Flash.SchDoc, M4F_MCU.SchDoc, M4F_MCU_Antennas.SchDoc, M4F_MCU_Power.SchDoc, Morpheus_middle.PcbDoc, Morpheus_middle.PrjPcb, Morpheus_middle.SchDoc]
2014-05-29 latest top board revision, just released to the fab
    [Bluetooth_MCU.SchDoc, Morpheus_top.PcbDoc, Morpheus_top.PrjPcb, Morpheus_top.SchDoc]
2014-05-29 AO3416 added
    [Hello.SchLib]
2014-05-29 C_0.1u_20_16_X7R_0603 added
    [Hello.SchLib]
2014-05-30 CC3200 updated with the correct footprint: PVQFN50P900X900X90-64
    [Hello.PcbLib, Hello.SchLib]
2014-05-31 MHDR2X10_SMD added with footprint
    [Hello.PcbLib, Hello.SchLib]
2014-05-31 RF layout done, keep going with the rest of the signals
    [Air_quality.SchDoc, Flash.SchDoc, M4F_MCU.SchDoc, M4F_MCU_Antennas.SchDoc, M4F_MCU_Power.SchDoc, Morpheus_middle.PcbDoc, Morpheus_middle.PrjPcb, Morpheus_middle.SchDoc]
2014-06-03 MHDR2X6_SMD added, HTU21D pinout fixed
    [Hello.PcbLib, Hello.SchLib]
2014-06-03 middle board ready for first review
    [Flash.SchDoc, M4F_MCU.SchDoc, Morpheus_middle.PcbDoc, Morpheus_middle.PrjPcb, Morpheus_middle.SchDoc, Morpheus_middle.csv]
2014-06-03 middel board updated with last power tracks
    [Morpheus_middle.PcbDoc, Morpheus_middle.PrjPcb]
2014-06-04 extra pads removed from MHDR headers
    [Hello.PcbLib]
2014-06-04 updated bottom board with HTUD21D correct orientation
    [Hello.PcbLib, Morpheus_bottom.PcbDoc, Morpheus_middle.PcbDoc, Morpheus_top.PrjPcb, Power_management.SchDoc, Temperature_humidity.SchDoc]
2014-06-04 first debugging header connected, RF layout revisited according to Dyke's advice
    [Air_quality.SchDoc, Flash.SchDoc, M4F_MCU.SchDoc, M4F_MCU_Power.SchDoc, Morpheus_middle.PrjPcb, Morpheus_middle.SchDoc, Morpheus_middle_with_headers.PcbDoc]
2014-06-04 R_2.7k_5_0.1_0402 added
    [Hello.SchLib]
2014-06-04 R_1.5k_1_0.1_0603 and R_2.7k_1_0.1_0603 added
    [Hello.SchLib]
2014-06-04 DEA202450BT-1294C1-H added
    [Hello.PcbLib, Hello.SchLib]
2014-06-05 middle board layout done for now, added a saw filter on the rf line
    [Air_quality.SchDoc, Flash.SchDoc, Hello.SchLib, M4F_MCU.SchDoc, M4F_MCU_Antennas.SchDoc, M4F_MCU_Power.SchDoc, Morpheus_middle.PcbDoc, Morpheus_middle.PrjPcb]
2014-06-05 RF part improved by removing relief around vias
    [Flash.SchDoc, M4F_MCU_Antennas.SchDoc, Morpheus_middle.PcbDoc, Morpheus_middle.PrjPcb]
2014-06-06 INMP footprints updated to remove soldermask from holes
    [Hello.PcbLib]
2014-06-06 molex_47420-0001 added, all molex components updated to comply with IPC nomenclature
    [Hello.PcbLib, Hello.SchLib]
2014-06-06 molex updated now
    [Hello.PcbLib, Hello.SchLib]
2014-06-07 commit before cleaning up folder structure
    [Hello.SchLib, Morpheus_bottom.PcbDoc, Morpheus_bottom.PrjPcb, Morpheus_bottom.SchDoc, Morpheus_middle.PcbDoc, Morpheus_middle.PrjPcb, Morpheus_middle.SchDoc, Morpheus_middle.csv]
2014-06-07 Big clean up. Removing everything but top board
    [54mm Board.DXF, ADC Reference voltage.SchDoc, ADC.SchDoc, ADC1.SchDoc, ADC2.SchDoc, ADC3.SchDoc, ADC4.SchDoc, ADC5.SchDoc]
2014-07-23 commit before adding codec
    [905-00003DXF.DXF, ALS.SchDoc, Antenna_sketch.DWG, Bluetooth_MCU.SchDoc, Bluetooth_MCU_QFN.SchDoc, Bottom USB Board.DXF, Microphone.SchDoc, Morpheus_top.PcbDoc]
2014-07-30 codec added, need to move nRF to QFN package
    [ALS.SchDoc, Bluetooth_MCU.SchDoc, Bluetooth_MCU_QFN.SchDoc, Codec.SchDoc, Microphone.SchDoc, Morpheus_top.PrjPcb, Morpheus_top.SchDoc, Morpheus_top_meander_only.PcbDoc]
2014-09-06 just got updated files from Dyke
    [ALS.SchDoc, ALS.SchLib, Bluetooth_MCU.SchDoc, Codec.SchDoc, Microphone.SchDoc, Morpheus_top.PcbDoc, Morpheus_top.PrjPcb, Morpheus_top.SchDoc]
2014-09-12 flipped PCB antenna to improve layout
    [Bluetooth_MCU.SchDoc, Codec.SchDoc, Microphone.SchDoc, Morpheus_top.DWG, Morpheus_top.PcbDoc, Morpheus_top.PcbLib, Morpheus_top.PrjPcb, Morpheus_top.SchDoc]
2014-09-12 top board back to Dyke, a few crystals changed and components added in Hello libraries
    [Bluetooth_MCU.SchDoc, Codec.SchDoc, Microphone.SchDoc, Morpheus_top.PcbDoc, Morpheus_top.PrjPcb, Morpheus_top.SchDoc, Morpheus_top.xlsx, Proximity.SchDoc]
2014-09-15 Top board EVT2
    [ALS.SchDoc, Bluetooth_MCU.SchDoc, Codec.SchDoc, Memory.SchDoc, Morpheus_top.PcbDoc, Morpheus_top.PrjPcb, Morpheus_top.SchDoc, Proximity.SchDoc]
2014-09-17 Top Board EVT2 revised
    some components got updated from the libraries
    [Bluetooth_MCU.SchDoc, Codec.SchDoc, Microphone.SchDoc, Morpheus_top.PcbDoc, Morpheus_top.PrjPcb, Morpheus_top.SchDoc]
2014-09-23 New files sent off to Rocket
    [Bluetooth_MCU.SchDoc, Codec.SchDoc, Microphone.SchDoc, Morpheus_top.PcbDoc, Morpheus_top.PrjPcb, Morpheus_top.SchDoc]
2014-09-30 Top board EVT3
    [905-00003-EVT2.DXF, 905-00003-EVT3onetoone (1).DXF, 905-00003-EVT3onetoone-speakerbox.DXF, ALS.SchDoc, Bluetooth_MCU.SchDoc, Codec.SchDoc, Microphone.SchDoc, Morpheus_top.PcbDoc]
2014-10-28 Antenna changed as per consultant's advice. About to introduce larger footprints
    [ALS.SchDoc, Bluetooth_MCU.SchDoc, Codec.SchDoc, Microphone.SchDoc, Morpheus_top.DWG, Morpheus_top.PcbDoc, Morpheus_top.PrjPcb, Morpheus_top.SchDoc]
2014-11-20 DVT Release of Morpheus Top Board on 11/17/2014
    DVT Release of Morpheus Top Board (905-00003-04) on 11/17/2014.
    This release was sent to Jabil for the DVT build.
    [40mm board.DXF, 905-00003-04-DVTd.DWG, 905-00003-EVT2.DXF, 905-00003-EVT3onetoone (1).DXF, 905-00003-EVT3onetoone-speakerbox.DXF, 905-00003DXF.DXF, ALS.SchDoc, Antenna_sketch.DWG]
2014-11-21 DVT Release ECO2014119-0002
    Minor tweak to the design triggered by a non-tented via under the
    speaker.
    Changes:
    - Fix missing via tent on top
    - Fix missing "Controlled Impedance" statement on FAB drawing
    - Minor, non-netlist routing improvement to improve RF (Johanson
    recommendation)
    [Morpheus ECO2014119-0002.xls, Morpheus_top.PcbDoc]
2015-01-10 PVT Release of Morpheus Top Board on 12/30/2014
    PVT Release of Morpheus Top Board (905-00003-05) on 12/30/2014.
    This release was sent to Jabil for the PVT/MP build.
    - Change BOB connector holes to be smaller (.305mm vias) and tent
    top-side to guarantee seal for acoustics. (MFG Yield Issue)
    - Mask solder paste mask on BOB connector bottom-side to leave ENIG
    surface for test probes. (Test Yield Issue)
    - Change PN in drawings and silk. (Update to match revised PNs)
    - Change Copyright text to be "(C) 2014 <LOGO> Hello Inc." (Update for
    Production)
    - Update FAB notes to specify IPC4101/126 and pre-approve ITEQ IT-180A
    material (From DVT EQs)
    - Update FAB notes to clarify 50 Ohm controlled impeda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
    [Morpheus_top.PcbDoc, Morpheus_top.PrjPcb]
2015-06-29 Mass production version (1/15)
    [Morpheus ECO2014119-0002.xls, Morpheus_top.PcbDoc, Morpheus_top.PrjPcb]
2015-06-29 cost reduction version for NPI build
    [ALS.SchDoc, Bluetooth_MCU.SchDoc, Codec.SchDoc, Microphone.SchDoc, Morpheus_top.PrjPcb, Morpheus_top.SchDoc, Proximity.SchDoc, Speaker.SchDoc]
